rcls/discus/README.md

Discus is an 8-bit CPU built from discrete transistors.
[Refer to the website for documentation](http://rcls.github.io/discus)
