rcls/discus/docs/notps.md

# notps.sch schematic
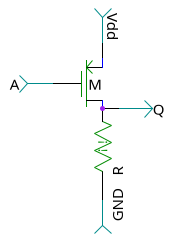
[picture p2: docs/notps.png]
notps.sch
