rcls/discus/docs/dram32byte.md

# dram32byte.sch schematic
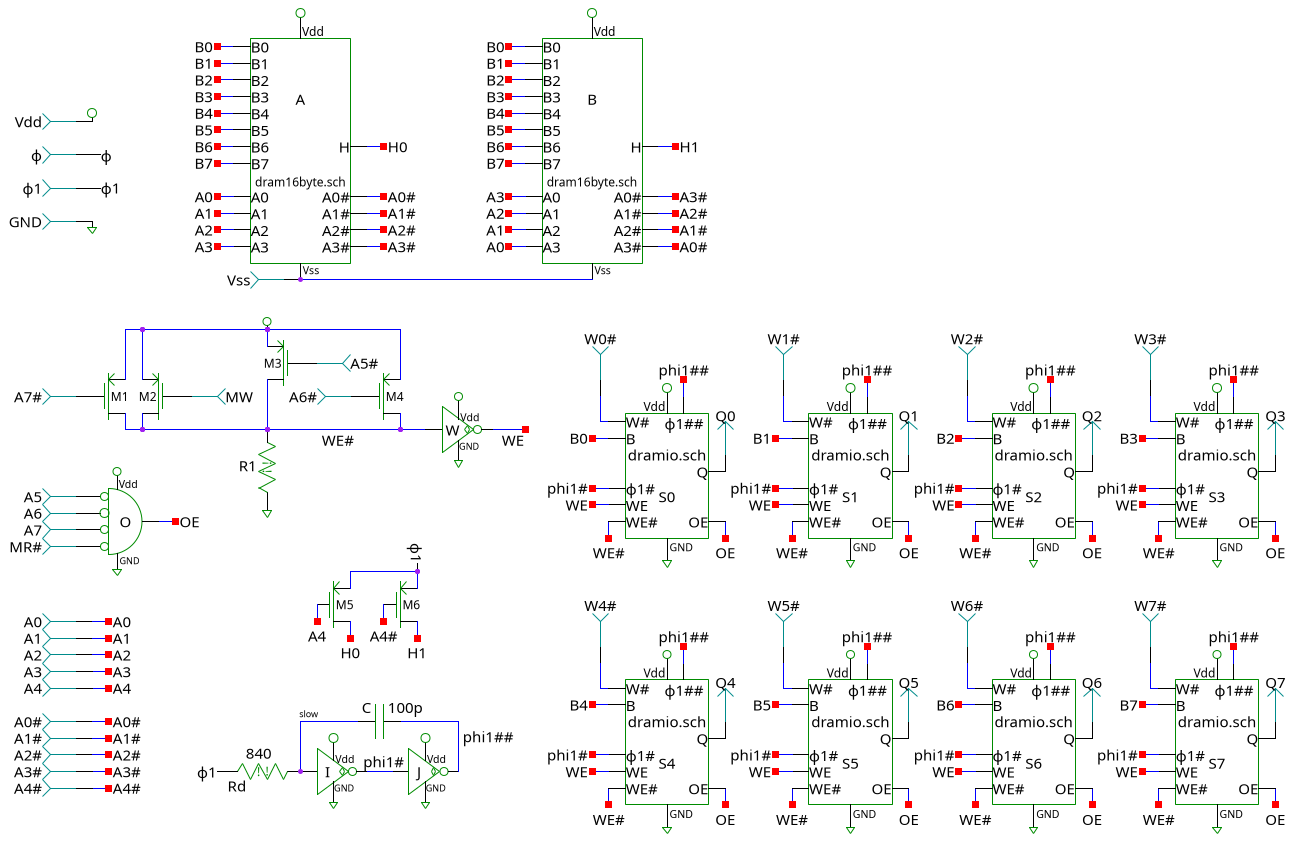
[picture p3: docs/dram32byte.png]
dram32byte.sch

# Gates in dram32byte.sch
dram16byte
dramio
nor4
cnot
