rcls/discus/docs/dram64byte.md

# dram64byte.sch schematic
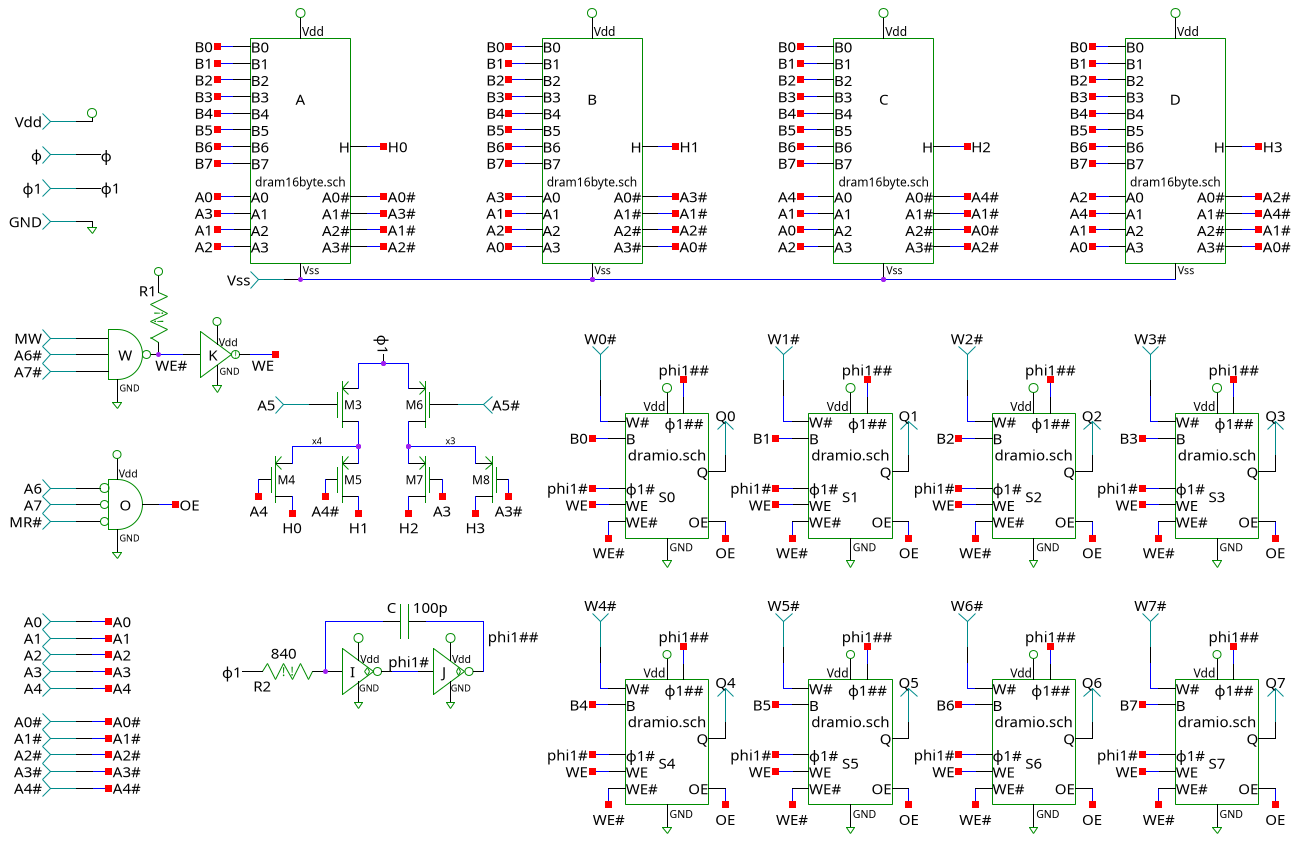
[picture p4: docs/dram64byte.png]
dram64byte.sch

# Gates in dram64byte.sch
dram16byte
dramio
nor3
nand3od
nots
cnot
