rcls/discus/docs/dramio.md

# dramio.sch schematic
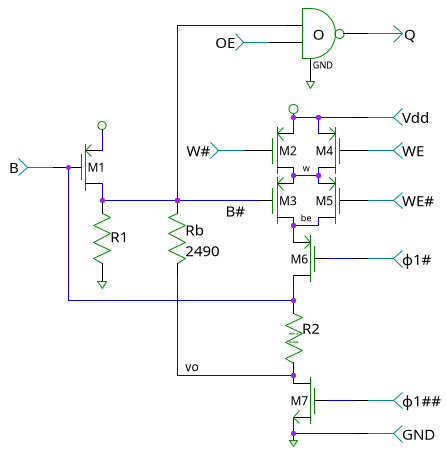
[picture p5: docs/dramio.png]
dramio.sch

# Gates in dramio.sch
nandod
