rcls/discus/docs/fivepd.md

# fivepd.sch schematic
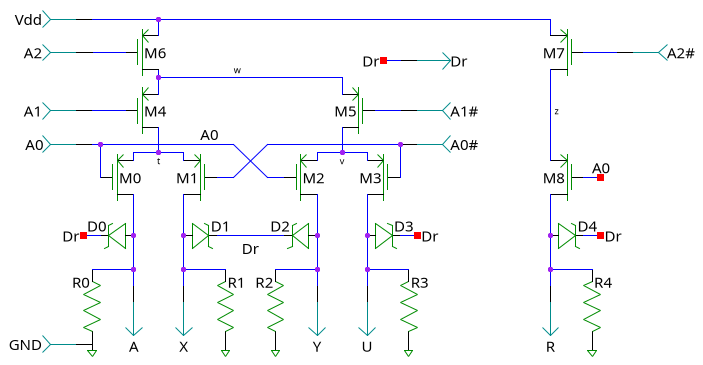
[picture p6: docs/fivepd.png]
fivepd.sch
