rcls/discus/docs/halfadd.md

# halfadd.sch schematic
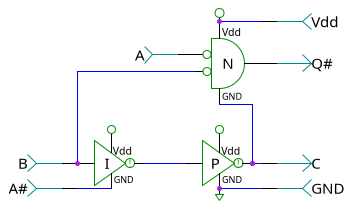
[picture p7: docs/halfadd.png]
halfadd.sch

# Gates in halfadd.sch
nots
nor
