rcls/discus/docs/nands.md

# nands.sch schematic
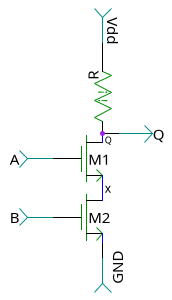
[picture p8: docs/nands.png]
nands.sch
