rcls/discus/docs/nors.md

# nors.sch schematic
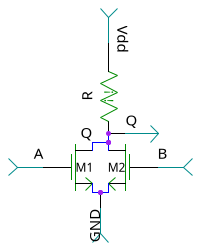
[picture p9: docs/nors.png]
nors.sch
