rcls/discus/docs/rom32byte.md

# rom32byte.sch schematic
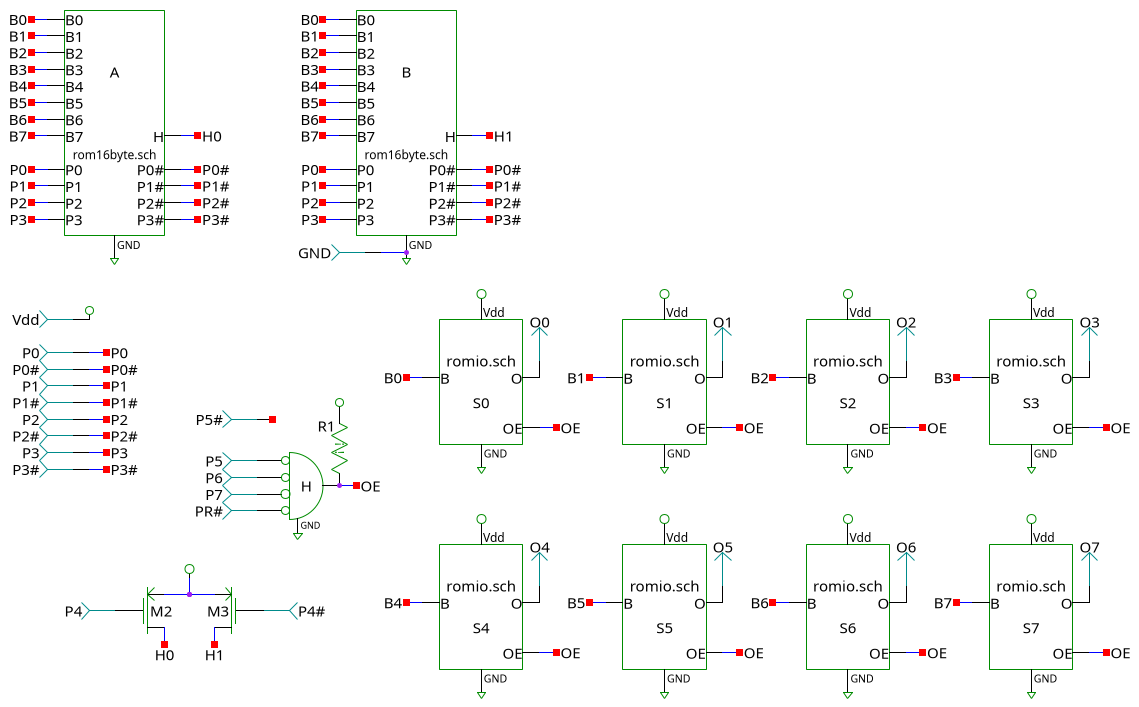
[picture p10: docs/rom32byte.png]
rom32byte.sch

# Gates in rom32byte.sch
rom16byte
romio
nor4od
