rcls/discus/docs/rom64byte.md

# rom64byte.sch schematic
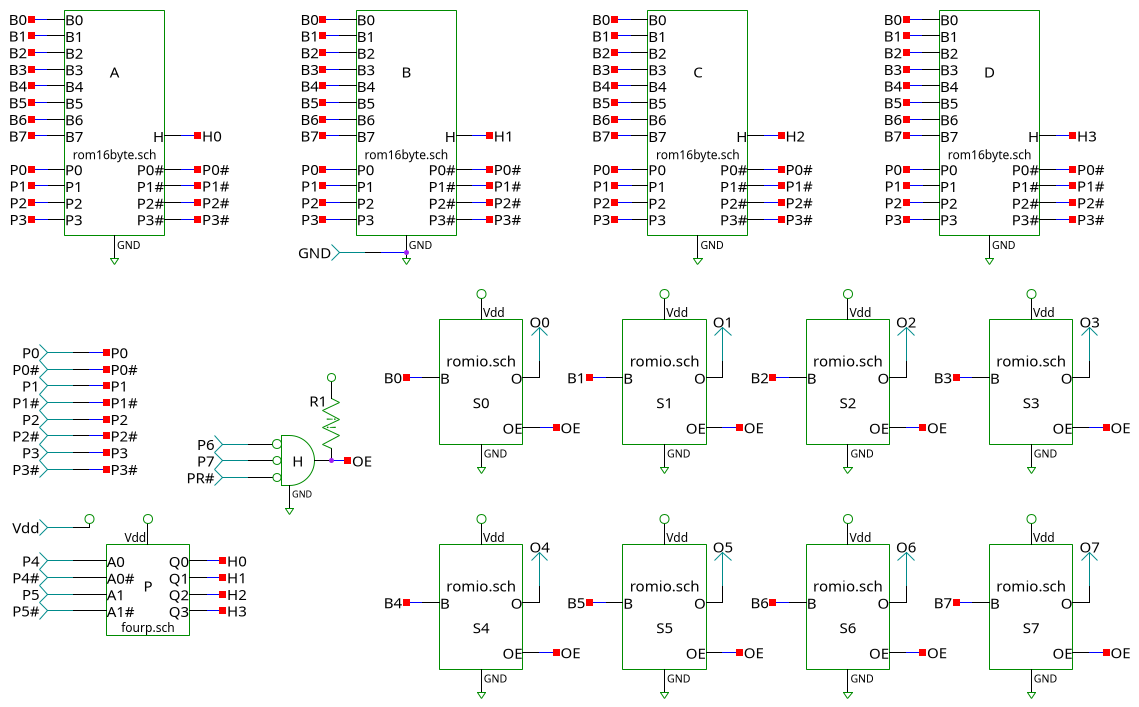
[picture p11: docs/rom64byte.png]
rom64byte.sch

# Gates in rom64byte.sch
rom16byte
romio
nor3od
fourp
