rcls/discus/docs/selis.md

# selis.sch schematic
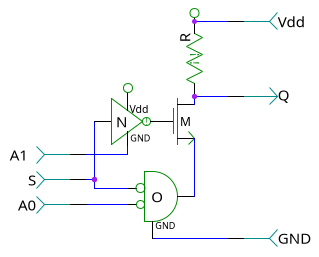
[picture p12: docs/selis.png]
selis.sch

# Gates in selis.sch
nots
norod
