rcls/discus/docs/sp.md

# sp.sch schematic
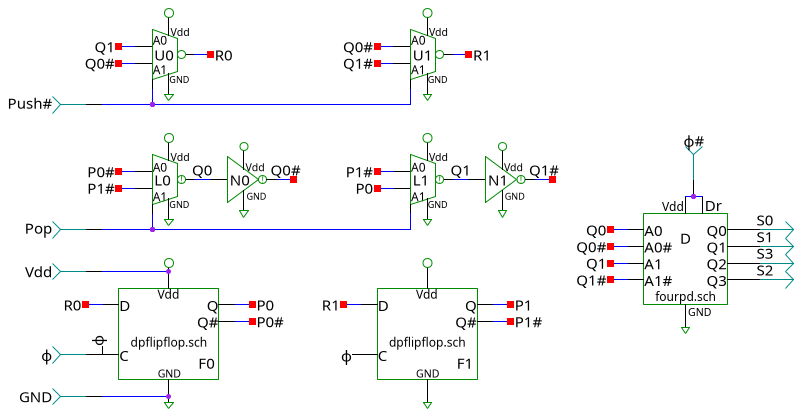
[picture p13: docs/sp.png]
sp.sch

# Gates in sp.sch
dpflipflop
selis
seli
nots
fourpd
