rcls/discus/docs/xnors.md

# xnors.sch schematic
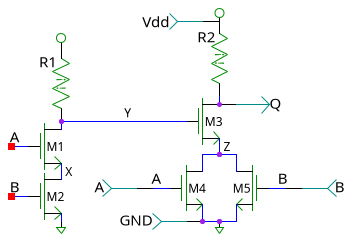
[picture p14: docs/xnors.png]
xnors.sch
