rcls/discus/docs/romio.md

# romio.sch schematic
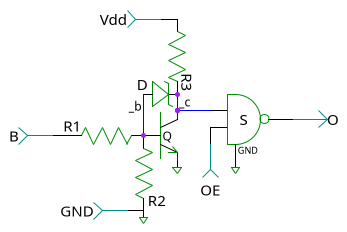
[picture p15: docs/romio.png]
romio.sch

# Gates in romio.sch
nandod
