rcls/discus/docs/fiveof8.md

# fiveof8.sch schematic
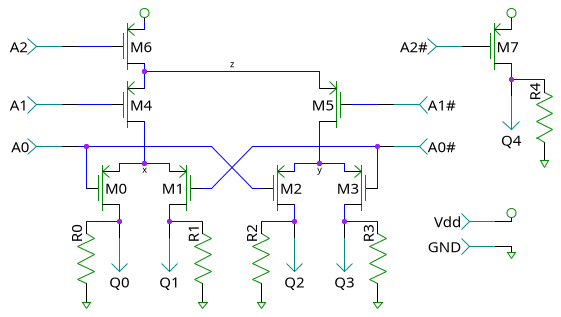
[picture p16: docs/fiveof8.png]
fiveof8.sch
