rcls/discus/docs/deflipflop.md

# deflipflop.sch schematic
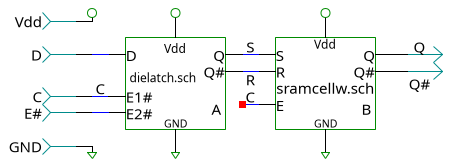
[picture p17: docs/deflipflop.png]
deflipflop.sch

# Gates in deflipflop.sch
sramcellw
dielatch
