rcls/discus/docs/dielatch.md

# dielatch.sch schematic
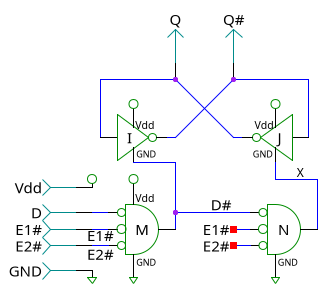
[picture p18: docs/dielatch.png]
dielatch.sch

# Gates in dielatch.sch
not
nor3
nor3od
