rcls/discus/docs/alu.md

# alu.sch schematic
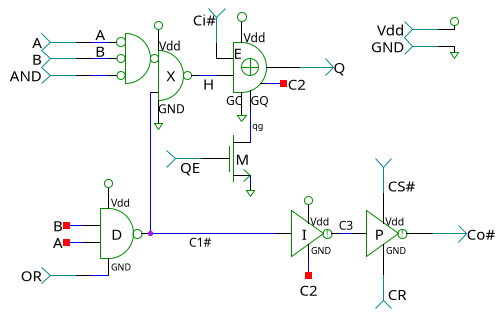
[picture p19: docs/alu.png]
alu.sch

# Gates in alu.sch
nand1or3
xor2g
nand
nots
