rcls/discus/docs/nots.md

# nots.sch schematic
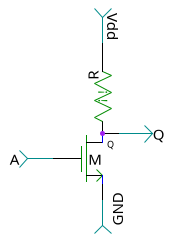
[picture p20: docs/nots.png]
nots.sch
