rcls/discus/docs/sramcell2t.md

# sramcell2t.sch schematic
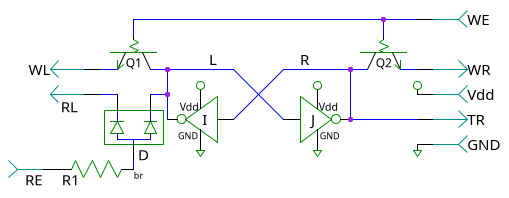
[picture p21: docs/sramcell2t.png]
sramcell2t.sch

# Gates in sramcell2t.sch
not
