rcls/discus/docs/nand3od.md

# nand3od.sch schematic
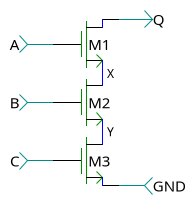
[picture p22: docs/nand3od.png]
nand3od.sch
