rcls/discus/docs/sramcellsw.md

# sramcellsw.sch schematic
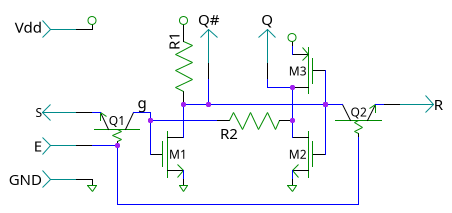
[picture p23: docs/sramcellsw.png]
sramcellsw.sch
