rcls/discus/docs/nor4od.md

# nor4od.sch schematic
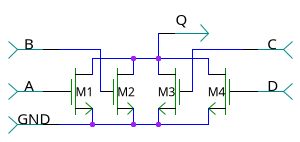
[picture p24: docs/nor4od.png]
nor4od.sch
