rcls/discus/docs/fourp.md

# fourp.sch schematic
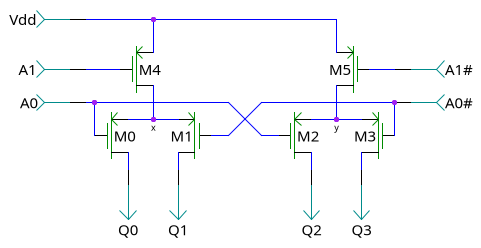
[picture p25: docs/fourp.png]
fourp.sch
