rcls/discus/docs/noverlap.md

# noverlap.sch schematic
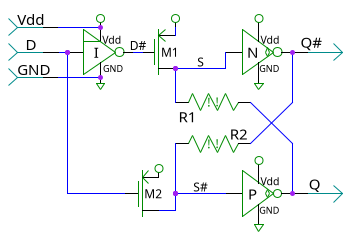
[picture p26: docs/noverlap.png]
noverlap.sch

# Gates in noverlap.sch
notp
cnot
