rcls/discus/docs/rom16byte.md

# rom16byte.sch schematic
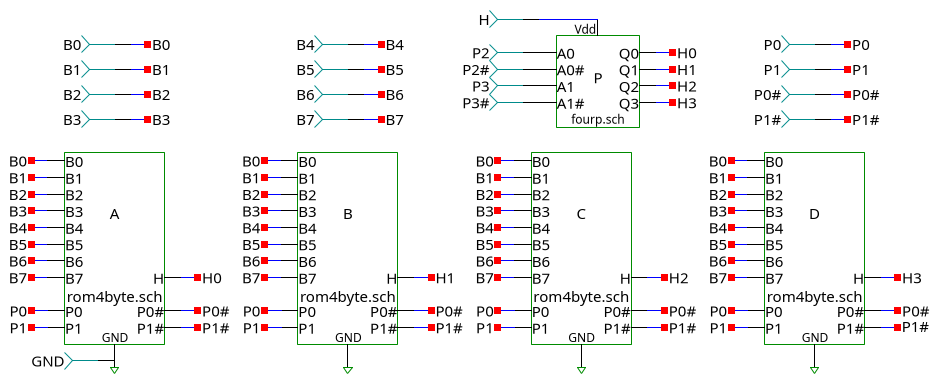
[picture p27: docs/rom16byte.png]
rom16byte.sch

# Gates in rom16byte.sch
rom4byte
fourp
