rcls/discus/docs/univlight.md

# univlight.sch schematic
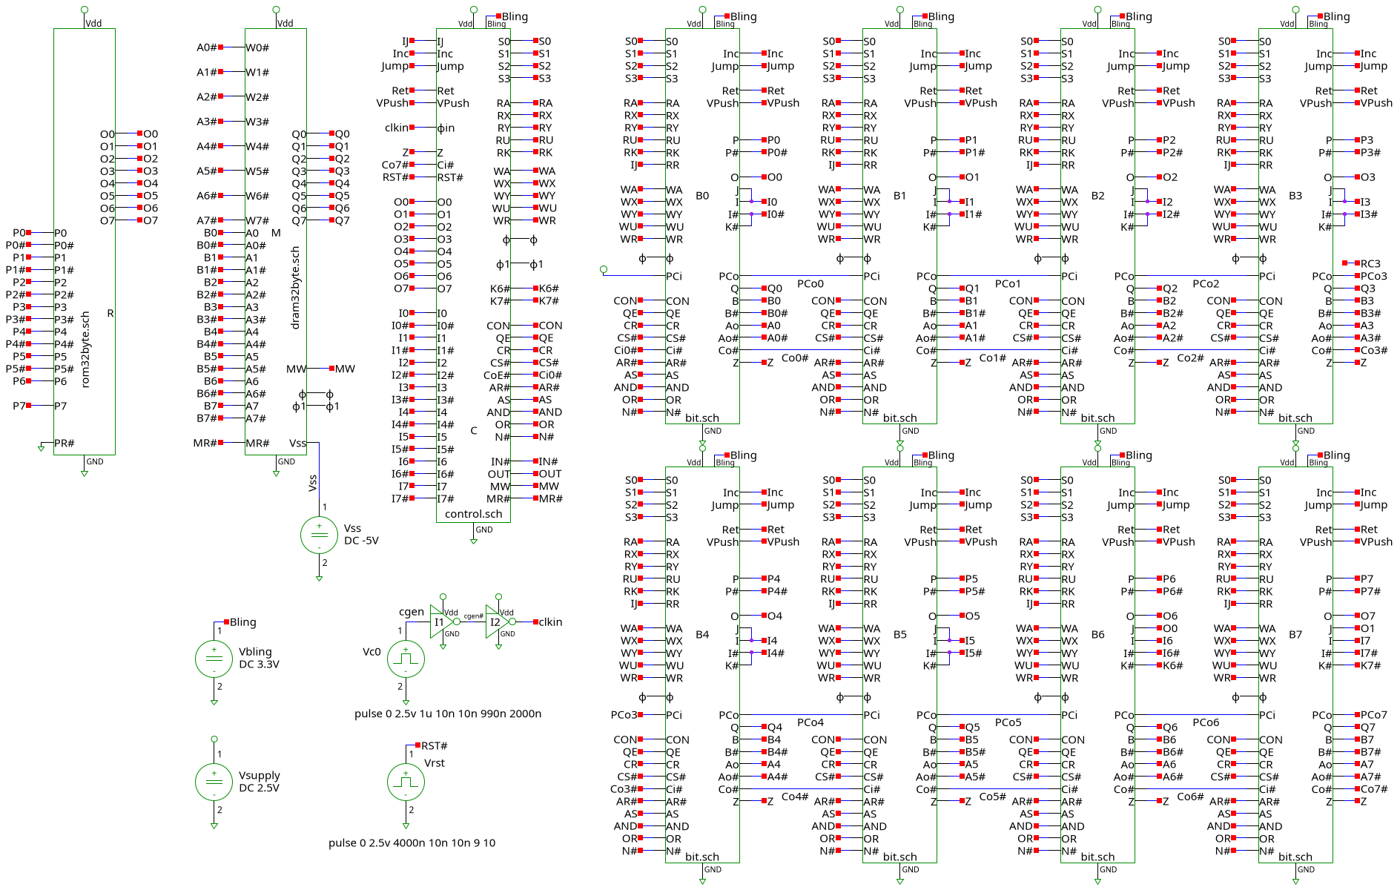
[picture p28: docs/univlight.png]
univlight.sch

# Gates in univlight.sch
rom64byte
control
bit
notp
dram64byte
