rcls/discus/docs/dflipflops.md

# dflipflops.sch schematic
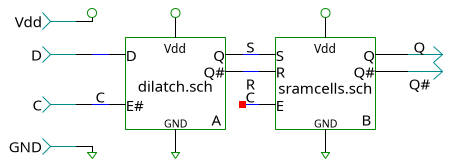
[picture p29: docs/dflipflops.png]
dflipflops.sch

# Gates in dflipflops.sch
sramcells
dilatch
