rcls/discus/docs/dilatch.md

# dilatch.sch schematic
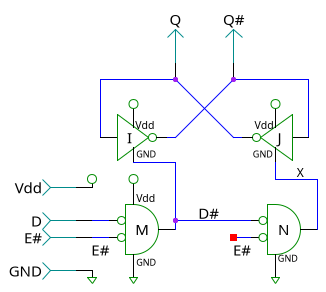
[picture p30: docs/dilatch.png]
dilatch.sch

# Gates in dilatch.sch
not
nor
norod
