rcls/discus/docs/diplatch.md

# diplatch.sch schematic
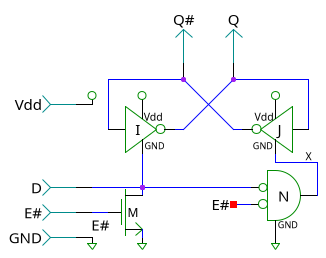
[picture p31: docs/diplatch.png]
diplatch.sch

# Gates in diplatch.sch
not
norod
