rcls/discus/docs/dpflipflop.md

# dpflipflop.sch schematic
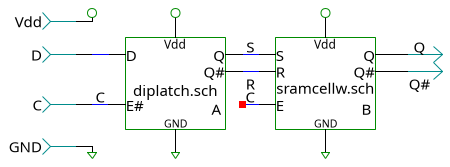
[picture p32: docs/dpflipflop.png]
dpflipflop.sch

# Gates in dpflipflop.sch
sramcellw
diplatch
