rcls/discus/docs/dpflipflops.md

# dpflipflops.sch schematic
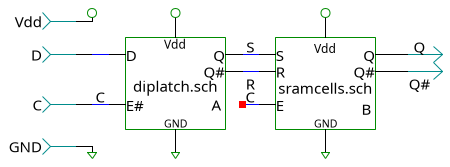
[picture p33: docs/dpflipflops.png]
dpflipflops.sch

# Gates in dpflipflops.sch
sramcells
diplatch
