rcls/discus/docs/sramcell2.md

# sramcell2.sch schematic
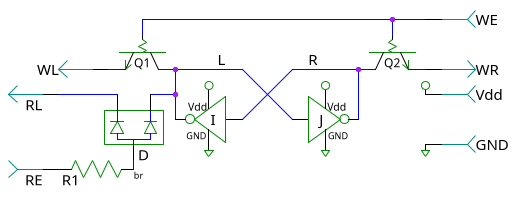
[picture p34: docs/sramcell2.png]
sramcell2.sch

# Gates in sramcell2.sch
not
