rcls/discus/docs/sramcells.md

# sramcells.sch schematic
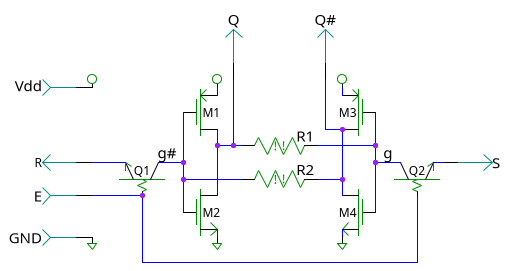
[picture p35: docs/sramcells.png]
sramcells.sch
