rcls/discus/docs/sramcellw.md

# sramcellw.sch schematic
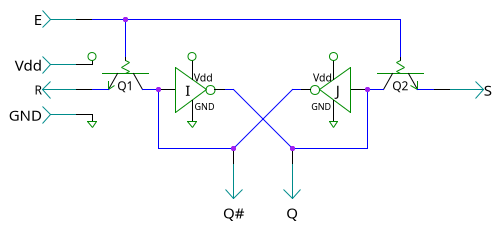
[picture p36: docs/sramcellw.png]
sramcellw.sch

# Gates in sramcellw.sch
not
