rcls/discus/docs/fourpd.md

# fourpd.sch schematic
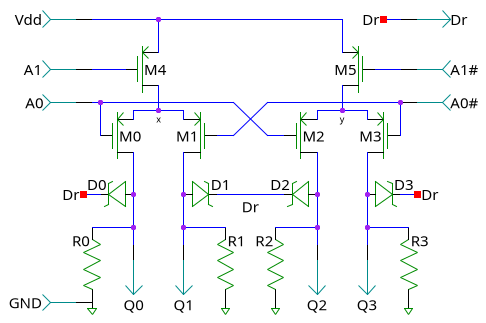
[picture p37: docs/fourpd.png]
fourpd.sch
