rcls/discus/docs/rom4byte.md

# rom4byte.sch schematic
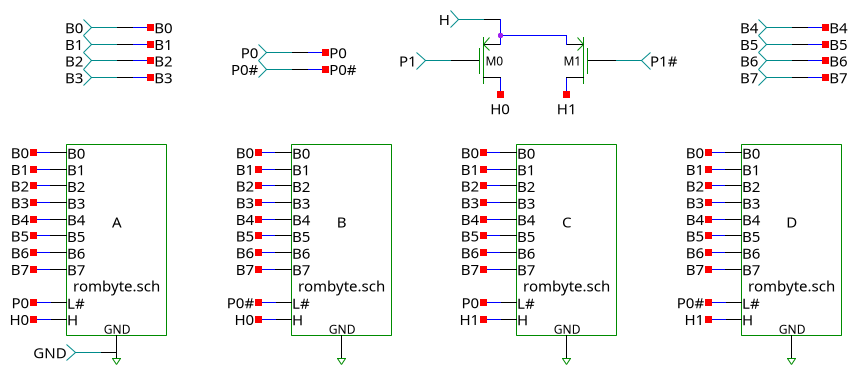
[picture p38: docs/rom4byte.png]
rom4byte.sch

# Gates in rom4byte.sch
rombyte
