rcls/discus/docs/rombyte.md

# rombyte.sch schematic
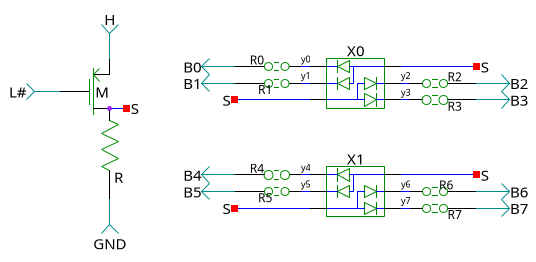
[picture p39: docs/rombyte.png]
rombyte.sch
