rcls/discus/docs/dram16byte.md

# dram16byte.sch schematic
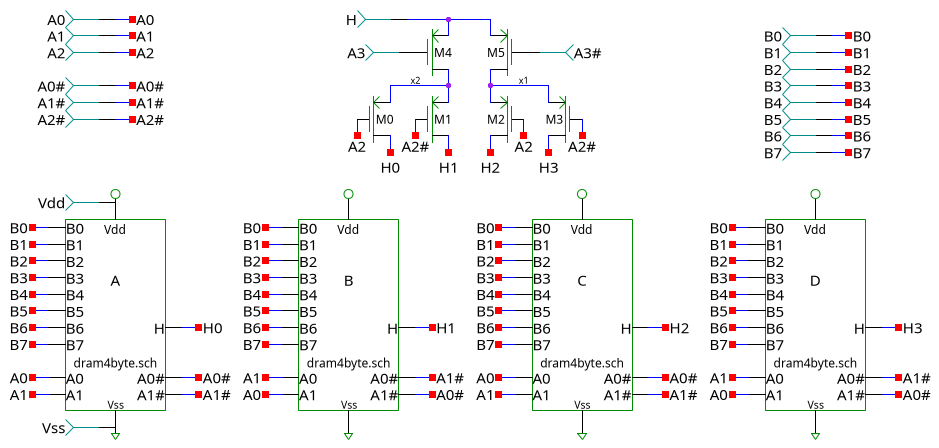
[picture p40: docs/dram16byte.png]
dram16byte.sch

# Gates in dram16byte.sch
dram4byte
