rcls/discus/docs/dram4byte.md

# dram4byte.sch schematic
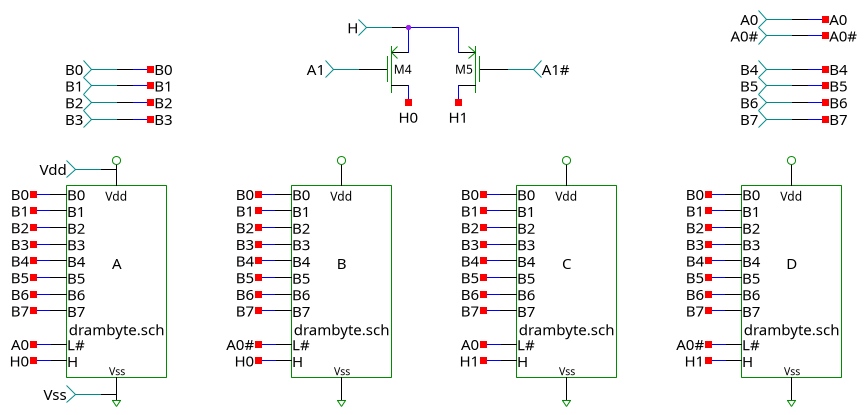
[picture p41: docs/dram4byte.png]
dram4byte.sch

# Gates in dram4byte.sch
drambyte
