rcls/discus/docs/seli.md

# seli.sch schematic
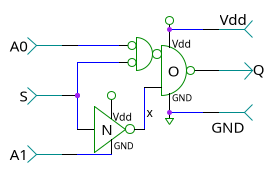
[picture p42: docs/seli.png]
seli.sch

# Gates in seli.sch
nand1or
not
