rcls/discus/docs/xnor.md

# xnor.sch schematic
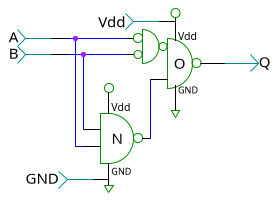
[picture p43: docs/xnor.png]
xnor.sch

# Gates in xnor.sch
nand
nand1or
