rcls/discus/docs/xor.md

# xor.sch schematic
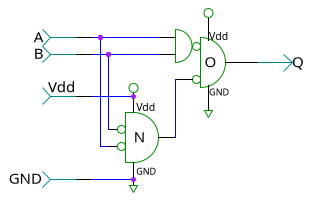
[picture p44: docs/xor.png]
xor.sch

# Gates in xor.sch
nor
nor1and
