rcls/discus/docs/xor2g.md

# xor2g.sch schematic
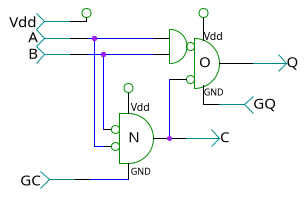
[picture p45: docs/xor2g.png]
xor2g.sch

# Gates in xor2g.sch
nor
nor1and
