rcls/discus/docs/drambyte.md

# drambyte.sch schematic
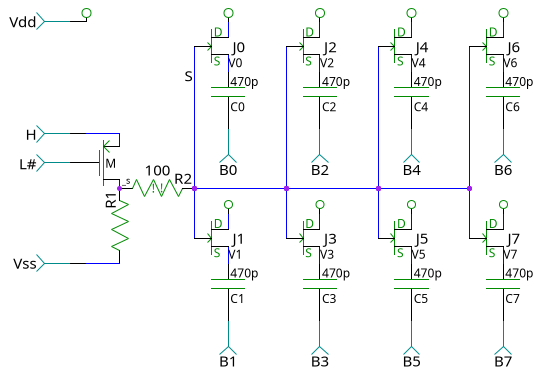
[picture p46: docs/drambyte.png]
drambyte.sch
