rcls/discus/docs/andnand.md

# andnand.sch schematic
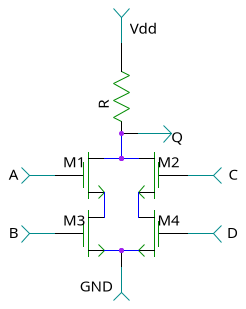
[picture p47: docs/andnand.png]
andnand.sch
