rcls/discus/docs/cnot.md

# cnot.sch schematic
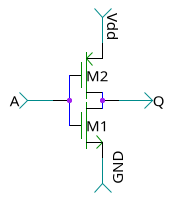
[picture p48: docs/cnot.png]
cnot.sch
