rcls/discus/docs/nand.md

# nand.sch schematic
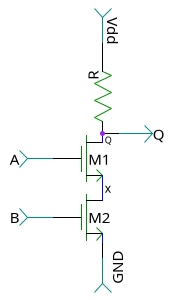
[picture p49: docs/nand.png]
nand.sch
