rcls/discus/docs/nand1or.md

# nand1or.sch schematic
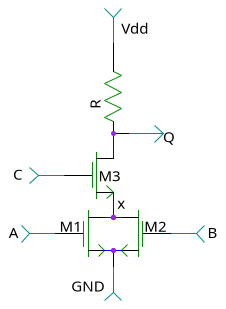
[picture p50: docs/nand1or.png]
nand1or.sch
