rcls/discus/docs/nand1or3.md

# nand1or3.sch schematic
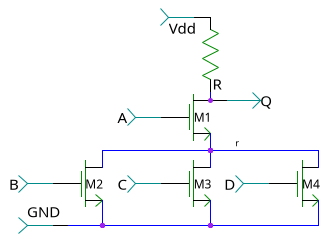
[picture p51: docs/nand1or3.png]
nand1or3.sch
