rcls/discus/docs/nand3.md

# nand3.sch schematic
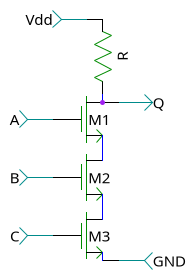
[picture p52: docs/nand3.png]
nand3.sch
