rcls/discus/docs/nandod.md

# nandod.sch schematic
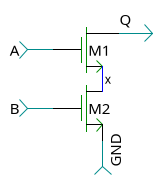
[picture p53: docs/nandod.png]
nandod.sch
