rcls/discus/docs/nor1and.md

# nor1and.sch schematic
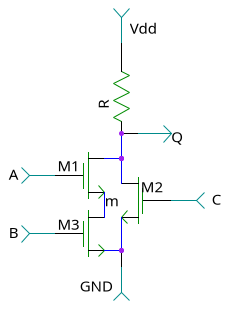
[picture p54: docs/nor1and.png]
nor1and.sch
