rcls/discus/docs/nor3.md

# nor3.sch schematic
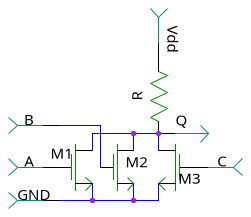
[picture p55: docs/nor3.png]
nor3.sch
