rcls/discus/docs/nor3od.md

# nor3od.sch schematic
nor3od.sch
