rcls/discus/docs/nor4.md

# nor4.sch schematic
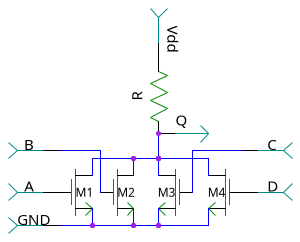
[picture p56: docs/nor4.png]
nor4.sch
