rcls/discus/docs/norod.md

# norod.sch schematic
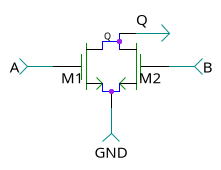
[picture p57: docs/norod.png]
norod.sch
