rcls/discus/docs/notb.md

# notb.sch schematic
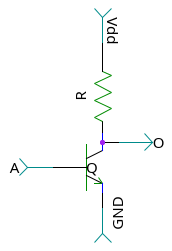
[picture p58: docs/notb.png]
notb.sch
