rcls/discus/docs/notp.md

# notp.sch schematic
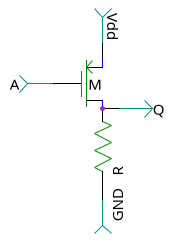
[picture p59: docs/notp.png]
notp.sch
