rcls/discus/docs/sramcell.md

# sramcell.sch schematic
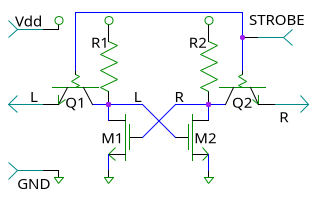
[picture p60: docs/sramcell.png]
sramcell.sch
