rcls/discus/docs/sramcell2s.md

# sramcell2s.sch schematic
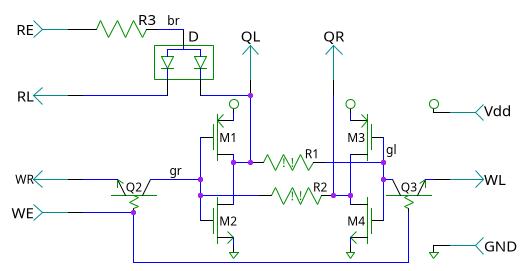
[picture p61: docs/sramcell2s.png]
sramcell2s.sch
