rcls/discus/io/tps7a7200.pins.txt

50mV 5
100mV 6
200mV 7
400mV 9
800mV 10
1.6V 11
EN 14
FB 3
GND 8,18
IN 15,16,17
NC 12
OUT 1,19,20
PG 4
SNS 2
SS 13
PAD 0
