rcls/discus/docs/bit.md

# bit.sch schematic
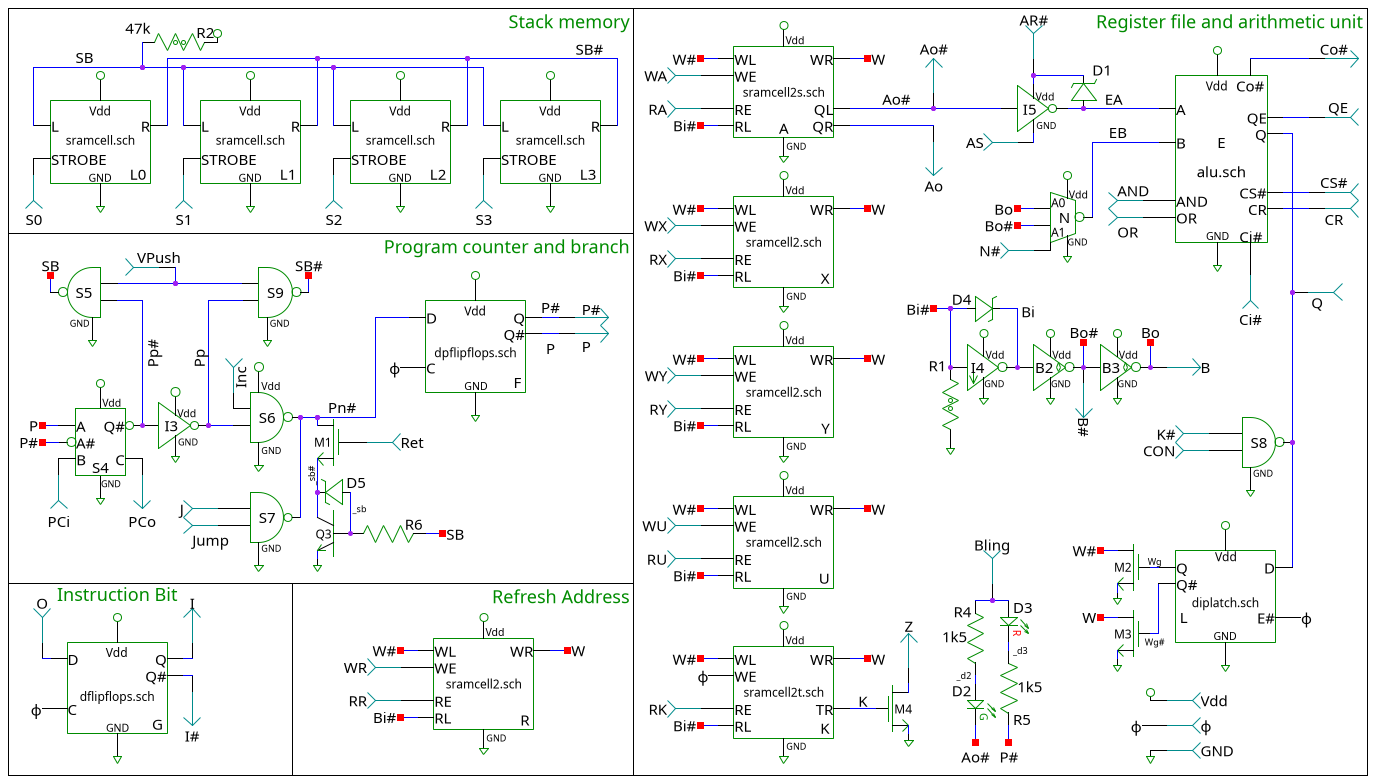
[picture p62: docs/bit.png]
bit.sch

# Gates in bit.sch
alu
sramcell2
sramcell2s
not
sramcell
dpflipflops
dflipflops
sramcell2t
nandod
notb
nand
cnot
seli
halfadd
diplatch
