rcls/discus/docs/decode.md

# decode.sch schematic
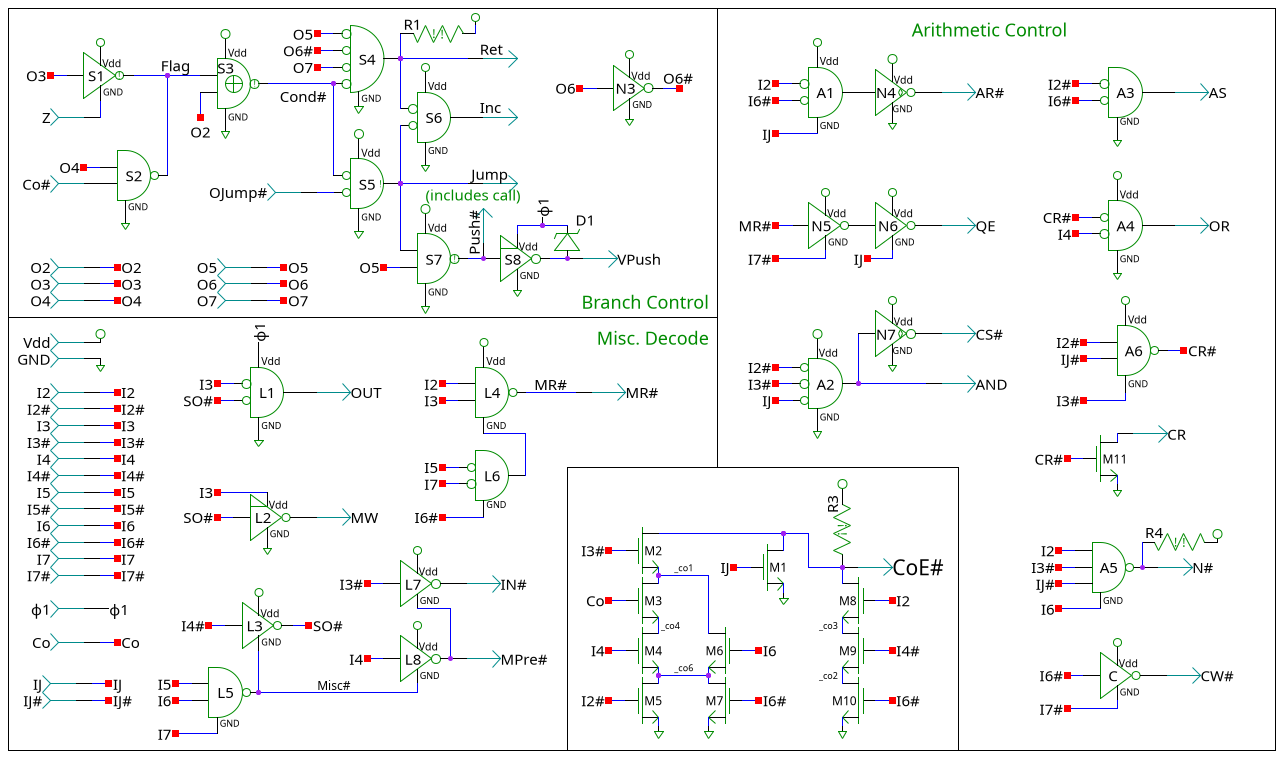
[picture p63: docs/decode.png]
decode.sch

# Gates in decode.sch
nors
nor
cnot
not
norod
xnors
notp
nands
nand3od
nor4od
nor3
nandod
nots
nand
