rcls/discus/docs/control.md

# control.sch schematic
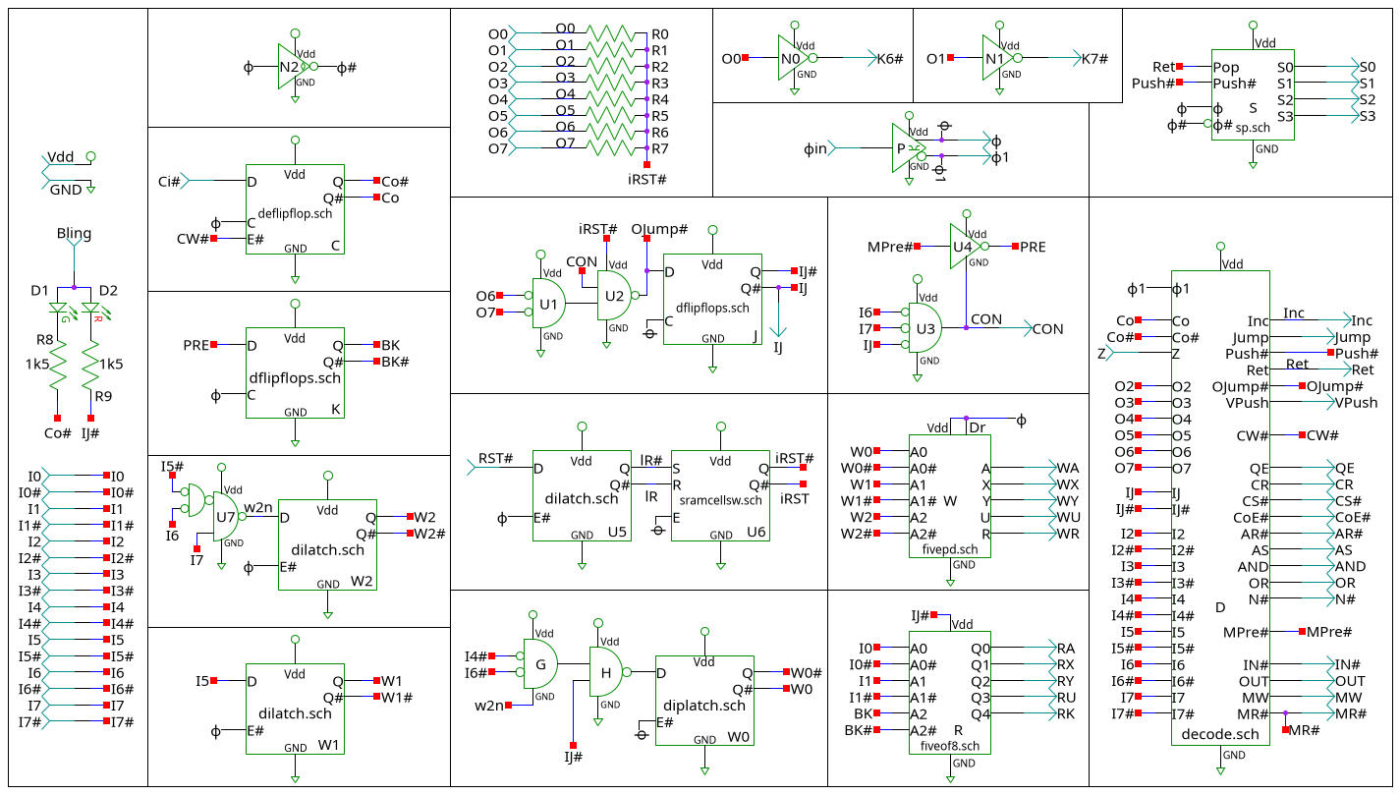
[picture p64: docs/control.png]
control.sch

# Gates in control.sch
deflipflop
dflipflops
not
sp
decode
nor
nor3
fivepd
noverlap
cnot
diplatch
dilatch
fiveof8
nand
sramcellsw
nand1or
