rcls/discus/docs/control-top.png

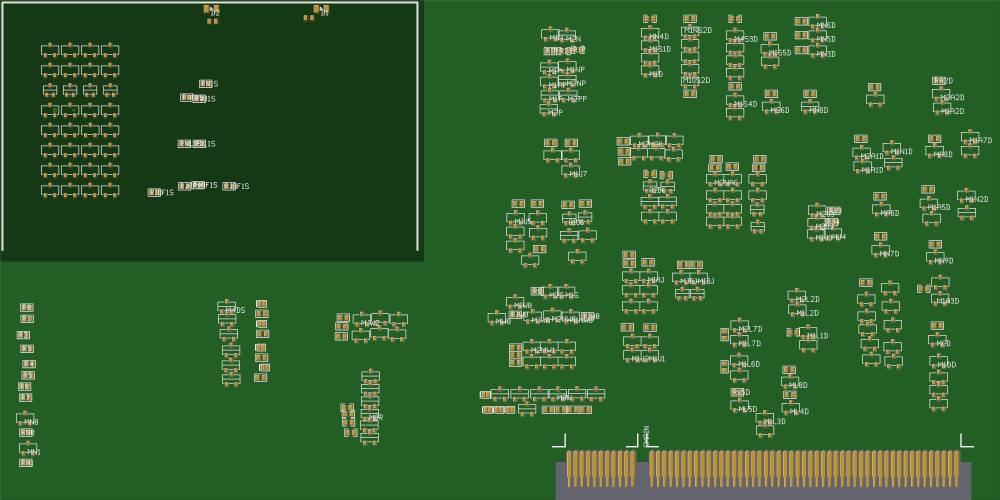
docs/control-top.png
