rcls/discus/(list of files, drawings)

Other design files:
board/bit-board.pcb
board/control-board.pcb
fp/pci-conn-3v.pcb
fp/pci-edge-3v.pcb
