rcls/discus/control-board.kicad_pcb

## KiCad design control-board.kicad_pcb (2026-03-17)

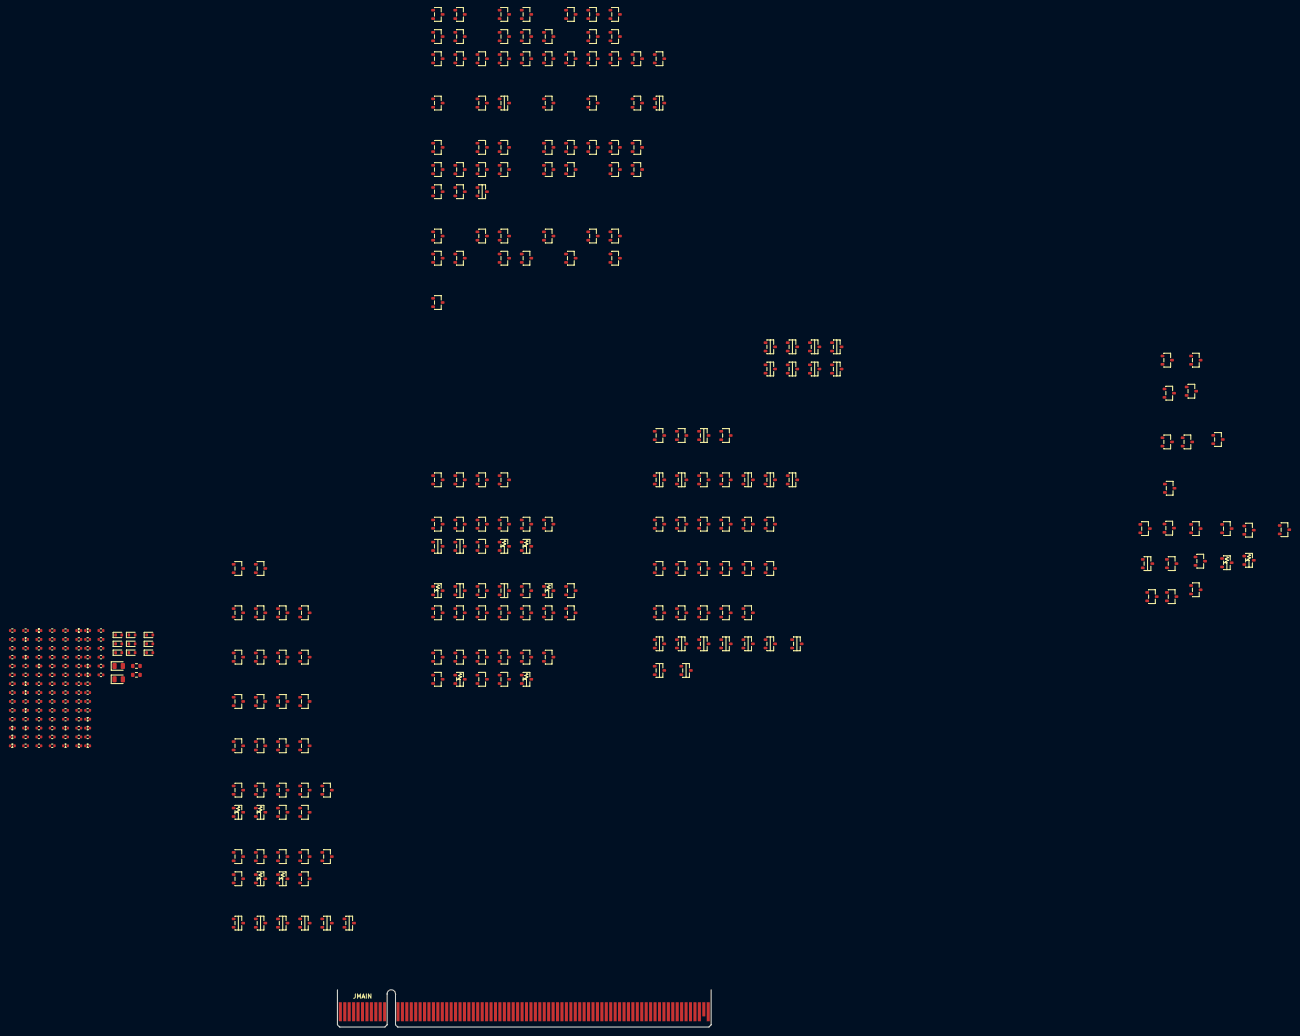
[picture p66: board control-board.kicad_pcb from above]

Board: 4 copper layers, 331 parts (0 on the bottom side), 182 nets, no tracks yet.

Parts:
D0DS, D0W, D1DS, D1W, D2DS, D2W, D3DS, D3W, D4W: RB751S40; SOD523
D1: ledgreen; 0805-diode
D2: ledred; 0805-diode
JMAIN: unknown; BUS_PCIexpress_x16
M0DS, M0R, M0W, M1BJ, M1BK, M1DS, M1P, M1R, M1W, M2DS, M2N2, M2N4D, M2N7D, M2NP, M2P, M2PP, M2R, M2W, M3BJ, M3BK, M3DS, M3R, M3U6, M3W, M4DS, M4R, M4W, M5DS, M5R, M5W, M6R, M6W, M7R, M7W, M8W: NX3008PBK; SOT23_pmos
M1A1D, M1A2D, M1A3D, M1A4D, M1A5D, M1A6D, M1D, M1G, M1H, M1L2D, M1L4D, M1L5D, M1L6D, M1MAC, M1MAJ, M1MAK, M1MU5, M1MW1, M1MW2, M1N2, M1N4D, M1N7D, M1NAC, M1NAF0S, M1NAF1S, M1NAJ, M1NAK, M1NP, M1NU5, M1NW0, M1NW1, M1NW2, M1OL0S, M1OL1S, M1OU0S, M1OU1S, M1PP, M1S2D, M1S3D, M1S4D, M1S5D, M1S6D, M1S7D, M1U1, M1U2, M1U3, M1U6, M1U7, M2A1D, M2A2D, M2A3D, M2A4D, M2A5D, M2A6D, M2BJ, M2BK, M2D, M2G, M2H, M2L2D, M2L4D, M2L5D, M2L6D, M2MAC, M2MAJ, M2MAK, M2MU5, M2MW1, M2MW2, M2NAC, M2NAF0S, M2NAF1S, M2NAJ, M2NAK, M2NU5, M2NW0, M2NW1, M2NW2, M2OL0S, M2OL1S, M2OU0S, M2OU1S, M2S2D, M2S3D, M2S4D, M2S5D, M2S6D, M2S7D, M2U1, M2U2, M2U3, M2U6, M2U7, M3A2D, M3A5D, M3D, M3MAC, M3NAC, M3OU0S, M3OU1S, M3S3D, M3S4D, M3U3, M3U7, M4BJ, M4BK, M4D, M4S3D, M4S4D, M5D, M5S3D, M6D, M7D, M8D, M9D, M10D, M11D: FDV301N; SOT23_nmos
MAF0S, MAF1S: FDV301N; SOT23_nmos
MCD: FDV301N; SOT23_nmos
MIAC: FDV301N; SOT23_nmos
MIAF0S, MIAF1S: FDV301N; SOT23_nmos
MIAJ: FDV301N; SOT23_nmos
MIAK: FDV301N; SOT23_nmos
MIBC: FDV301N; SOT23_nmos
MIBF0S, MIBF1S: FDV301N; SOT23_nmos
MIP: NX3008PBK; SOT23_pmos
MIU5: FDV301N; SOT23_nmos
MIW0, MIW1, MIW2: FDV301N; SOT23_nmos
MJAC: FDV301N; SOT23_nmos
MJAF0S, MJAF1S: FDV301N; SOT23_nmos
MJAJ: FDV301N; SOT23_nmos
MJAK: FDV301N; SOT23_nmos
MJBC: FDV301N; SOT23_nmos
MJBF0S, MJBF1S: FDV301N; SOT23_nmos
MJU5: FDV301N; SOT23_nmos
MJW0, MJW1, MJW2: FDV301N; SOT23_nmos
ML0S, ML1D, ML1S, ML3D, ML7D, ML8D: FDV301N; SOT23_nmos
MN0, MN0S, MN1, MN1S, MN3D, MN5D, MN6D: FDV301N; SOT23_nmos
MNL0S, MNL1S: FDV301N; SOT23_nmos
MNU0S, MNU1S: FDV301N; SOT23_nmos
MS1D: FDV301N; SOT23_nmos
MS8D: NX3008PBK; SOT23_pmos
MU4: FDV301N; SOT23_nmos
MW0: FDV301N; SOT23_nmos
Q1BC, Q1BF0S, Q1BF1S, Q1BJ, Q1BK, Q1U6, Q2BC, Q2BF0S, Q2BF1S, Q2BJ, Q2BK, Q2U6: PDTC124TU; SOT23_bias
R0, R0DS, R0R, R0W, R1, R1DS, R1R, R1U6, R1W, R2, R2DS, R2R, R2U6, R2W, R3, R3DS, R3R, R3W, R4, R4R, R4W, R5, R6, R7: 2k49; R_0402_load
R1BJ, R1BK, R1D, R1P, R1S3D, R2BJ, R2BK, R2P, R2S3D, R3D, R4D: 820; R_0402_strong
R8, R9: 1k5; 0603
RA1D, RA2D, RA4D, RA6D: 2k49; R_0402_load
RCD: 2k49; R_0402_load
RG: 2k49; R_0402_load
RH: 2k49; R_0402_load
RIAC: 2k49; R_0402_load
RIAF0S, RIAF1S: 2k49; R_0402_load
RIAJ: 2k49; R_0402_load
RIAK: 2k49; R_0402_load
RIBC: 2k49; R_0402_load
RIBF0S, RIBF1S: 2k49; R_0402_load
RIP: 2k49; R_0402_load
RIU5: 2k49; R_0402_load
RIW0, RIW1, RIW2: 2k49; R_0402_load
RJAC: 2k49; R_0402_load
RJAF0S, RJAF1S: 2k49; R_0402_load
RJAJ: 2k49; R_0402_load
RJAK: 2k49; R_0402_load
RJBC: 2k49; R_0402_load
RJBF0S, RJBF1S: 2k49; R_0402_load
RJU5: 2k49; R_0402_load
RJW0, RJW1, RJW2: 2k49; R_0402_load
RL0S, RL1S, RL2D: 820; R_0402_strong
RL1D, RL3D, RL4D, RL7D, RL8D: 2k49; R_0402_load
RMAC: 2k49; R_0402_load
RMAJ: 2k49; R_0402_load
RMAK: 2k49; R_0402_load
RMU5: 2k49; R_0402_load
RMW1, RMW2: 2k49; R_0402_load
RN0, RN1, RN3D, RN5D, RN6D: 2k49; R_0402_load
RN0S, RN1S: 820; R_0402_strong
RNL0S, RNL1S: 820; R_0402_strong
RNU0S, RNU1S: 2k49; R_0402_load
ROU0S, ROU1S: 2k49; R_0402_load
RS1D, RS5D, RS7D: 820; R_0402_strong
RS6D, RS8D: 2k49; R_0402_load
RU1, RU2, RU3, RU4, RU7: 2k49; R_0402_load

Connections:
AND: JMAIN.B60, M1A2D.3 (D), M1N7D.1 (G), M2A2D.3 (D), M2N7D.1 (G), M3A2D.3 (D), RA2D.1
AR#: JMAIN.B58, M1N4D.3 (D), M2N4D.3 (D)
AS: JMAIN.B59, M1A3D.3 (D), M2A3D.3 (D)
BK: M1BK.3 (D), M2BK.3 (D), M6R.1 (G), R1BK.1
BK#: M3BK.3 (D), M4BK.3 (D), M7R.1 (G), R2BK.2
Bling: D1.2, D2.2, JMAIN.B67
CON: JMAIN.B53, M1U2.1 (G), M1U3.3 (D), M2U3.3 (D), M3U3.3 (D), MU4.2 (S), RU3.1
CR: JMAIN.B55, M11D.3 (D)
CR#_D: M1A4D.1 (G), M1A6D.3 (D), M11D.1 (G), RA6D.1
CS#: JMAIN.B56, M1N7D.3 (D), M2N7D.3 (D)
CW#: M3MAC.1 (G), M3NAC.1 (G), MCD.3 (D), RCD.1
Ci#: JMAIN.B7, M1MAC.1 (G)
Co: M3D.1 (G), MIBC.1 (G), MJBC.3 (D), Q1BC.3, RJBC.1
Co#: M2S2D.1 (G), MIBC.3 (D), MJBC.1 (G), Q2BC.3, R8.1, RIBC.1
CoE#: JMAIN.B57, M1D.3 (D), M2D.3 (D), M8D.3 (D), R3D.1
Cond#_D: M1S5D.1 (G), M3S3D.3 (D), M4S4D.1 (G), R2S3D.1
D#_A_C: M1MAC.3 (D), M1NAC.1 (G), M2MAC.3 (D), M3MAC.3 (D), MIAC.2 (S), RMAC.1
D#_A_J: M1MAJ.3 (D), M1NAJ.1 (G), M2MAJ.3 (D), MIAJ.2 (S), RMAJ.1
D#_A_K: M1MAK.3 (D), M1NAK.1 (G), M2MAK.3 (D), MIAK.2 (S), RMAK.1
D#_U5: M1MU5.3 (D), M1NU5.1 (G), M2MU5.3 (D), MIU5.2 (S), RMU5.1
D#_W1: M1MW1.3 (D), M1NW1.1 (G), M2MW1.3 (D), MIW1.2 (S), RMW1.1
D#_W2: M1MW2.3 (D), M1NW2.1 (G), M2MW2.3 (D), MIW2.2 (S), RMW2.1
Flag_D: M1S2D.3 (D), M1S3D.1 (G), M4S3D.1 (G), MS1D.3 (D), RS1D.1
GND: JMAIN.B34, M1A2D.2 (S), M1A3D.2 (S), M1A4D.2 (S), M1D.2 (S), M1L2D.2 (S), M1MAC.2 (S), M1MAJ.2 (S), M1MAK.2 (S), M1MU5.2 (S), M1MW1.2 (S), M1MW2.2 (S), M1N2.2 (S), M1N4D.2 (S), M1N7D.2 (S), M1NAC.2 (S), M1NAF0S.2 (S), M1NAF1S.2 (S), M1NAJ.2 (S), M1NAK.2 (S), M1NP.2 (S), M1NU5.2 (S), M1NW0.2 (S), M1NW1.2 (S), M1NW2.2 (S), M1OL0S.2 (S), M1OL1S.2 (S), M1OU0S.2 (S), M1OU1S.2 (S), M1PP.2 (S), M1S4D.2 (S), M1S5D.2 (S), M1S6D.2 (S), M1U1.2 (S), M1U3.2 (S), M1U6.2 (S), M1U7.2 (S), M2A2D.2 (S), M2A3D.2 (S), M2A4D.2 (S), M2BJ.2 (S), M2BK.2 (S), M2H.2 (S), M2L2D.2 (S), M2MAC.2 (S), M2MAJ.2 (S), M2MAK.2 (S), M2MU5.2 (S), M2MW1.2 (S), M2MW2.2 (S), M2NAC.2 (S), M2NAF0S.2 (S), M2NAF1S.2 (S), M2NAJ.2 (S), M2NAK.2 (S), M2NU5.2 (S), M2NW0.2 (S), M2NW1.2 (S), M2NW2.2 (S), M2OL0S.2 (S), M2OL1S.2 (S), M2OU0S.2 (S), M2OU1S.2 (S), M2S2D.2 (S), M2S3D.2 (S), M2S4D.2 (S), M2S5D.2 (S), M2S6D.2 (S), M2S7D.2 (S), M2U1.2 (S), M2U2.2 (S), M2U3.2 (S), M2U6.2 (S), M2U7.2 (S), M3A2D.2 (S), M3MAC.2 (S), M3NAC.2 (S), M3S4D.2 (S), M3U3.2 (S), M4BJ.2 (S), M4BK.2 (S), M4S3D.2 (S), M4S4D.2 (S), M5D.2 (S), M5S3D.2 (S), M7D.2 (S), M10D.2 (S), M11D.2 (S), MAF0S.2 (S), MAF1S.2 (S), MIBC.2 (S), MIBF0S.2 (S), MIBF1S.2 (S), MJBC.2 (S), MJBF0S.2 (S), MJBF1S.2 (S), MN0.2 (S), MN0S.2 (S), MN1.2 (S), MN1S.2 (S), MN3D.2 (S), MW0.2 (S), R0DS.1, R0R.1, R0W.1, R1DS.1, R1R.1, R1W.1, R2DS.1, R2R.1, R2W.1, R3DS.1, R3R.1, R3W.1, R4R.1, R4W.1, RIP.1, RS8D.1
I0: JMAIN.B17, M0R.1 (G), M2R.1 (G)
I0#: JMAIN.B18, M1R.1 (G), M3R.1 (G)
I1: JMAIN.B19, M4R.1 (G)
I1#: JMAIN.B20, M5R.1 (G)
I2: JMAIN.B21, M1A1D.1 (G), M1A5D.1 (G), M1L4D.1 (G), M8D.1 (G)
I2#: JMAIN.B22, M1A2D.1 (G), M1A3D.1 (G), M1A6D.1 (G), M5D.1 (G)
I3: JMAIN.B23, M2L4D.1 (G)
I3#: JMAIN.B24, M1L2D.1 (G), M2A2D.1 (G), M2A5D.1 (G), M2A6D.2 (S), M2D.1 (G), ML1D.1 (G), ML7D.1 (G)
I4: JMAIN.B25, M2A4D.1 (G), M4D.1 (G), ML8D.1 (G)
I4#: JMAIN.B26, M1G.1 (G), M9D.1 (G), ML3D.1 (G)
I5: JMAIN.B27, M1L6D.1 (G), M1MW1.1 (G)
I5#: JMAIN.B28, M1U7.1 (G), M2L5D.2 (S)
I6: JMAIN.B29, M1L5D.1 (G), M1U3.1 (G), M2U7.1 (G), M3A5D.2 (S), M6D.1 (G)
I6#: JMAIN.B30, M1L6D.2 (S), M2A1D.1 (G), M2A3D.1 (G), M2G.1 (G), M2L6D.2 (S), M7D.1 (G), M10D.1 (G), MCD.1 (G)
I7: JMAIN.B31, M2L6D.1 (G), M2U3.1 (G), M3U7.1 (G)
I7#: JMAIN.B32, M2L5D.1 (G), MCD.2 (S), MN5D.2 (S)
IJ: JMAIN.B68, M1A1D.2 (S), M1D.1 (G), M2A1D.2 (S), M3A2D.1 (G), M3BJ.3 (D), M3U3.1 (G), M4BJ.3 (D), MN6D.2 (S), R2BJ.2
IJ#: M1BJ.3 (D), M2A6D.1 (G), M2BJ.3 (D), M2H.1 (G), M3A5D.1 (G), M6R.2 (S), M7R.2 (S), R1BJ.1, R9.1
IN#: JMAIN.B63, ML7D.3 (D), RL7D.1
Inc: JMAIN.B1, M1S6D.3 (D), M2S6D.3 (D), RS6D.1
Jump: JMAIN.B2, M1S5D.3 (D), M1S7D.1 (G), M2S5D.3 (D), M2S6D.1 (G), RS5D.1
K6#: JMAIN.B51, MN0.3 (D), RN0.1
K7#: JMAIN.B52, MN1.3 (D), RN1.1
MPre#: ML7D.2 (S), ML8D.3 (D), MU4.1 (G), RL8D.1
MR#: JMAIN.B66, M1L4D.3 (D), MN5D.1 (G), RL4D.1
MW: JMAIN.B65, M1L2D.3 (D), M2L2D.3 (D), RL2D.1
Misc#_D: M1L5D.3 (D), ML3D.2 (S), ML8D.2 (S)
N#: JMAIN.B62, M1A5D.3 (D), R4D.2
O0: JMAIN.B9, MN0.1 (G), R0.1
O1: JMAIN.B10, MN1.1 (G), R1.1
O2: JMAIN.B11, M2S3D.1 (G), M5S3D.1 (G), R2.1
O3: JMAIN.B12, MS1D.1 (G), R3.1
O4: JMAIN.B13, M1S2D.1 (G), R4.1
O5: JMAIN.B14, M1S4D.1 (G), M2S7D.1 (G), R5.1
O6: JMAIN.B15, M1U1.1 (G), MN3D.1 (G), R6.1
O6#_D: M2S4D.1 (G), MN3D.3 (D), RN3D.1
O7: JMAIN.B16, M2U1.1 (G), M3S4D.1 (G), R7.1
OJump#: M1MAJ.1 (G), M1U2.3 (D), M2S5D.1 (G), RU2.1
OR: JMAIN.B61, M1A4D.3 (D), M2A4D.3 (D), RA4D.1
OUT#: JMAIN.B64, ML1D.3 (D), RL1D.1
P0#_S: M2OL0S.1 (G), MIBF0S.1 (G), MJBF0S.3 (D), Q1BF0S.3, RJBF0S.1
P0_S: MIBF0S.3 (D), MJBF0S.1 (G), MNL1S.2 (S), Q2BF0S.3, RIBF0S.1
P1#_S: M2OL1S.1 (G), MIBF1S.1 (G), MJBF1S.3 (D), MNL0S.2 (S), Q1BF1S.3, RJBF1S.1
P1_S: MIBF1S.3 (D), MJBF1S.1 (G), Q2BF1S.3, RIBF1S.1
PRE: M1MAK.1 (G), MU4.3 (D), RU4.1
Push#: M1S7D.3 (D), M2OU0S.1 (G), M2OU1S.1 (G), MNU0S.1 (G), MNU1S.1 (G), MS8D.1 (G), RS7D.1
Q0#_S: M1DS.1 (G), M1OU1S.1 (G), M3DS.1 (G), MN0S.3 (D), MNU0S.2 (S), RN0S.1
Q0_S: M0DS.1 (G), M2DS.1 (G), ML0S.3 (D), MN0S.1 (G), RL0S.1
Q1#_S: M5DS.1 (G), MN1S.3 (D), MNU1S.2 (S), RN1S.1
Q1_S: M1OU0S.1 (G), M4DS.1 (G), ML1S.3 (D), MN1S.1 (G), RL1S.1
QE: JMAIN.B54, MN6D.3 (D), RN6D.1
Q_A1_D: M1A1D.3 (D), M1N4D.1 (G), M2A1D.3 (D), M2N4D.1 (G), RA1D.1
Q_G: M1G.3 (D), M1H.1 (G), M2G.3 (D), RG.1
Q_H: M1H.3 (D), M1NW0.1 (G), MIW0.2 (S), MW0.3 (D), RH.1
Q_I_P: M1P.1 (G), MIP.3 (D), RIP.2
Q_L6_D: M1L6D.3 (D), M2L4D.2 (S), M2L6D.3 (D)
Q_N5_D: MN5D.3 (D), MN6D.1 (G), RN5D.1
Q_N_L0_S: ML0S.1 (G), MNL0S.3 (D), RNL0S.1
Q_N_L1_S: ML1S.1 (G), MNL1S.3 (D), RNL1S.1
Q_O_L0_S: M1OL0S.3 (D), M2OL0S.3 (D), ML0S.2 (S)
Q_O_L1_S: M1OL1S.3 (D), M2OL1S.3 (D), ML1S.2 (S)
Q_U1: M1U1.3 (D), M2U1.3 (D), M2U2.1 (G), RU1.1
R0_S: M1NAF0S.1 (G), M3OU0S.3 (D), MAF0S.3 (D), MIAF0S.2 (S), ROU0S.1
R1_S: M1NAF1S.1 (G), M3OU1S.3 (D), MAF1S.3 (D), MIAF1S.2 (S), ROU1S.1
RA: JMAIN.B39, M0R.3 (D), R0R.2
RK: JMAIN.B43, M7R.3 (D), R4R.2
RST#: JMAIN.B8, M1MU5.1 (G)
RU: JMAIN.B42, M3R.3 (D), R3R.2
RX: JMAIN.B40, M1R.3 (D), R1R.2
RY: JMAIN.B41, M2R.3 (D), R2R.2
R_C: MIAC.3 (D), MJAC.1 (G), Q1BC.2, RIAC.1
R_F0_S: MIAF0S.1 (G), MJAF0S.3 (D), Q1BF0S.2, RJAF0S.1
R_F1_S: MIAF1S.1 (G), MJAF1S.3 (D), Q1BF1S.2, RJAF1S.1
R_J: MIAJ.3 (D), MJAJ.1 (G), Q1BJ.2, RIAJ.1
R_K: MIAK.3 (D), MJAK.1 (G), Q1BK.2, RIAK.1
Ret: JMAIN.B3, M1OL0S.1 (G), M1OL1S.1 (G), M1S4D.3 (D), M1S6D.1 (G), M2S4D.3 (D), M3S4D.3 (D), M4S4D.3 (D), MNL0S.1 (G), MNL1S.1 (G), R1D.2
S0: D0DS.2, JMAIN.B35, M0DS.3 (D), R0DS.2
S1: D1DS.2, JMAIN.B36, M1DS.3 (D), R1DS.2
S2: D3DS.2, JMAIN.B37, M3DS.3 (D), R3DS.2
S3: D2DS.2, JMAIN.B38, M2DS.3 (D), R2DS.2
S#_P: M1PP.1 (G), M2P.3 (D), M2PP.1 (G), R2P.1
SO#_D: M2L2D.1 (G), ML1D.2 (S), ML3D.3 (D), RL3D.1
S_C: MIAC.1 (G), MJAC.3 (D), Q2BC.2, RJAC.1
S_F0_S: MIAF0S.3 (D), MJAF0S.1 (G), Q2BF0S.2, RIAF0S.1
S_F1_S: MIAF1S.3 (D), MJAF1S.1 (G), Q2BF1S.2, RIAF1S.1
S_J: MIAJ.1 (G), MJAJ.3 (D), Q2BJ.2, RJAJ.1
S_K: MIAK.1 (G), MJAK.3 (D), Q2BK.2, RJAK.1
S_P: M1NP.1 (G), M1P.3 (D), M2NP.1 (G), R1P.1
VPush: JMAIN.B4, MS8D.3 (D), RS8D.2
Vdd: JMAIN.B33, M1BJ.2 (S), M1BK.2 (S), M1P.2 (S), M2N2.2 (S), M2N4D.2 (S), M2N7D.2 (S), M2NP.2 (S), M2P.2 (S), M2PP.2 (S), M3BJ.2 (S), M3BK.2 (S), M3U6.2 (S), MIP.2 (S), R1D.1, R1S3D.2, R1U6.2, R2S3D.2, R3D.2, R4D.1, RA1D.2, RA2D.2, RA4D.2, RA6D.2, RCD.2, RG.2, RH.2, RIAC.2, RIAF0S.2, RIAF1S.2, RIAJ.2, RIAK.2, RIBC.2, RIBF0S.2, RIBF1S.2, RIU5.2, RIW0.2, RIW1.2, RIW2.2, RJAC.2, RJAF0S.2, RJAF1S.2, RJAJ.2, RJAK.2, RJBC.2, RJBF0S.2, RJBF1S.2, RJU5.2, RJW0.2, RJW1.2, RJW2.2, RL0S.2, RL1D.2, RL1S.2, RL2D.2, RL3D.2, RL4D.2, RL7D.2, RL8D.2, RMAC.2, RMAJ.2, RMAK.2, RMU5.2, RMW1.2, RMW2.2, RN0.2, RN0S.2, RN1.2, RN1S.2, RN3D.2, RN5D.2, RN6D.2, RNL0S.2, RNL1S.2, RNU0S.2, RNU1S.2, ROU0S.2, ROU1S.2, RS1D.2, RS5D.2, RS6D.2, RS7D.2, RU1.2, RU3.2, RU4.2, RU7.2
W0: M0W.1 (G), M2W.1 (G), M8W.1 (G), MIW0.1 (G), MJW0.3 (D), RJW0.1
W0#: M1W.1 (G), M3W.1 (G), MIW0.3 (D), MJW0.1 (G), RIW0.1
W1: M4W.1 (G), MIW1.1 (G), MJW1.3 (D), RJW1.1
W1#: M5W.1 (G), MIW1.3 (D), MJW1.1 (G), RIW1.1
W2: M6W.1 (G), MIW2.1 (G), MJW2.3 (D), RJW2.1
W2#: M7W.1 (G), MIW2.3 (D), MJW2.1 (G), RIW2.1
WA: D0W.2, JMAIN.B44, M0W.3 (D), R0W.2
WR: D4W.2, JMAIN.B69, M8W.3 (D), R4W.2
WU: D3W.2, JMAIN.B47, M3W.3 (D), R3W.2
WX: D1W.2, JMAIN.B45, M1W.3 (D), R1W.2
WY: D2W.2, JMAIN.B46, M2W.3 (D), R2W.2
X_A5_D: M1A5D.2 (S), M2A5D.3 (D)
X_A_C: M1NAC.3 (D), M2NAC.3 (D), M3NAC.3 (D), MJAC.2 (S)
X_A_F0_S: M1NAF0S.3 (D), M2NAF0S.3 (D), MJAF0S.2 (S)
X_A_F1_S: M1NAF1S.3 (D), M2NAF1S.3 (D), MJAF1S.2 (S)
X_A_J: M1NAJ.3 (D), M2NAJ.3 (D), MJAJ.2 (S)
X_A_K: M1NAK.3 (D), M2NAK.3 (D), MJAK.2 (S)
X_S3_D: M1S3D.2 (S), M2S3D.3 (D)
X_U5: M1NU5.3 (D), M2NU5.3 (D), MJU5.2 (S)
X_W0: M1NW0.3 (D), M2NW0.3 (D), MJW0.2 (S)
X_W1: M1NW1.3 (D), M2NW1.3 (D), MJW1.2 (S)
X_W2: M1NW2.3 (D), M2NW2.3 (D), MJW2.2 (S)
Y_A5_D: M2A5D.2 (S), M3A5D.3 (D)
Y_S3_D: M1S3D.3 (D), M3S3D.1 (G), R1S3D.1
Z: JMAIN.B6, MS1D.2 (S)
Z_S3_D: M3S3D.2 (S), M4S3D.3 (D), M5S3D.3 (D)
_co1_D: M2D.2 (S), M3D.3 (D), M6D.3 (D)
_co2_D: M9D.2 (S), M10D.3 (D)
_co3_D: M8D.2 (S), M9D.3 (D)
_co4_D: M3D.2 (S), M4D.3 (D)
_co6_D: M4D.2 (S), M5D.3 (D), M6D.2 (S), M7D.3 (D)
g#_B_J: M1BJ.1 (G), M2BJ.1 (G), Q1BJ.3, R2BJ.1
g#_B_K: M1BK.1 (G), M2BK.1 (G), Q1BK.3, R2BK.1
g_B_J: M3BJ.1 (G), M4BJ.1 (G), Q2BJ.3, R1BJ.2
g_B_K: M3BK.1 (G), M4BK.1 (G), Q2BK.3, R1BK.2
g_U6: M1U6.1 (G), Q1U6.3, R2U6.1
iRST: M1U6.3 (D), M2U6.1 (G), M3U6.1 (G), Q2U6.3, R1U6.1
iRST#: M2U6.3 (D), M3U6.3 (D), R0.2, R1.2, R2.2, R2U6.2, R3.2, R4.2, R5.2, R6.2, R7.2, RU2.2
lR: MIU5.3 (D), MJU5.1 (G), Q2U6.2, RIU5.1
lR#: MIU5.1 (G), MJU5.3 (D), Q1U6.2, RJU5.1
phi: D0W.1, D1W.1, D2W.1, D3W.1, D4W.1, JMAIN.B48, M1N2.1 (G), M1PP.3 (D), M2MAC.1 (G), M2MAJ.1 (G), M2MAK.1 (G), M2MU5.1 (G), M2MW1.1 (G), M2MW2.1 (G), M2N2.1 (G), M2NAC.1 (G), M2NAF0S.1 (G), M2NAF1S.1 (G), M2NAJ.1 (G), M2NAK.1 (G), M2NU5.1 (G), M2NW0.1 (G), M2NW1.1 (G), M2NW2.1 (G), M2PP.3 (D), M6W.2 (S), M7W.2 (S), MAF0S.1 (G), MAF1S.1 (G), MW0.1 (G), Q1BC.1, Q1BF0S.1, Q1BF1S.1, Q1BJ.1, Q1BK.1, Q1U6.1, Q2BC.1, Q2BF0S.1, Q2BF1S.1, Q2BJ.1, Q2BK.1, Q2U6.1, R1P.2
phi1: JMAIN.B50, M1NP.3 (D), M2NP.3 (D), MS8D.2 (S), R2P.2
phi#: D0DS.1, D1DS.1, D2DS.1, D3DS.1, M1N2.3 (D), M2N2.3 (D), M4DS.2 (S), M5DS.2 (S)
t_W: M0W.2 (S), M1W.2 (S), M4W.3 (D)
unnamed_net1: D1.1, R8.2
unnamed_net2: D2.1, R9.2
v_W: M2W.2 (S), M3W.2 (S), M5W.3 (D)
w2n: M1G.2 (S), M1MW2.1 (G), M2G.2 (S), M3U7.3 (D), RU7.1
w_W: M4W.2 (S), M5W.2 (S), M6W.3 (D)
x_A6_D: M1A6D.2 (S), M2A6D.3 (D)
x_D_S: M0DS.2 (S), M1DS.2 (S), M4DS.3 (D)
x_H: M1H.2 (S), M2H.3 (D)
x_L4_D: M1L4D.2 (S), M2L4D.3 (D)
x_L5_D: M1L5D.2 (S), M2L5D.3 (D)
x_O_U0_S: M1OU0S.3 (D), M2OU0S.3 (D), M3OU0S.2 (S)
x_O_U1_S: M1OU1S.3 (D), M2OU1S.3 (D), M3OU1S.2 (S)
x_R: M0R.2 (S), M1R.2 (S), M4R.3 (D)
x_S2_D: M1S2D.2 (S), M2S2D.3 (D)
x_S7_D: M1S7D.2 (S), M2S7D.3 (D)
x_U0_S: M3OU0S.1 (G), MNU0S.3 (D), RNU0S.1
x_U1_S: M3OU1S.1 (G), MNU1S.3 (D), RNU1S.1
x_U2: M1U2.2 (S), M2U2.3 (D)
x_U7: M1U7.3 (D), M2U7.3 (D), M3U7.2 (S)
y_D_S: M2DS.2 (S), M3DS.2 (S), M5DS.3 (D)
y_R: M2R.2 (S), M3R.2 (S), M5R.3 (D)
z_R: M4R.2 (S), M5R.2 (S), M6R.3 (D)
z_W: M7W.3 (D), M8W.2 (S)
ϕin: JMAIN.B5, M2P.1 (G), MIP.1 (G)
