rcls/discus/bit-board.kicad_pcb

## KiCad design bit-board.kicad_pcb (2026-03-17)

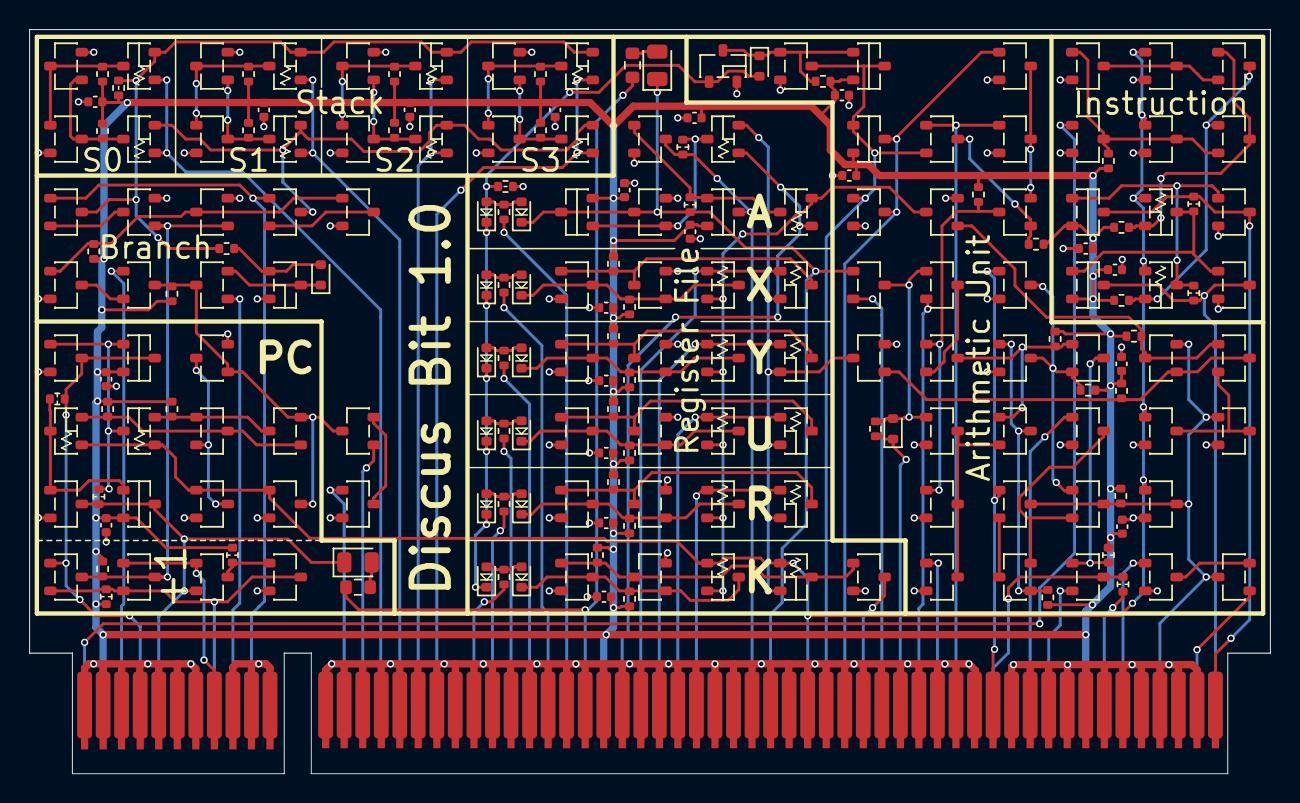
[picture p67: board bit-board.kicad_pcb from above]

Board: 4 copper layers, 85.0 x 51.0 mm, 209 parts (0 on the bottom side), 120 nets.

Parts:
C1, C2, C3, C4, C5, C6, C7, C8, C9, C10, C11, C12, C13, C14, C15, C16, C17, C18, C19, C20: 0.1u; C_0402
D1, D4, D5: RB751S40; SOD523
D1A, D1K, D1R, D1U, D1X, D1Y, D2A, D2K, D2R, D2U, D2X, D2Y: 1N4148WT; SOD523-diode
D2: ledgreen; 0805-diode
D3: ledred; 0805-diode
JMAIN: unknown; pci-edge-3v
M1, M1B2, M1B3, M1DE, M1L0, M1L1, M1L2, M1L3, M1MAG, M1NAF, M1NAG, M1NEE, M1NL, M1NS4, M1OEE, M1ON, M1S5, M1S6, M1S7, M1S8, M1S9, M1XE, M2, M2A, M2BF, M2BG, M2DE, M2L0, M2L1, M2L2, M2L3, M2MAG, M2NAF, M2NAG, M2NEE, M2NL, M2NS4, M2OEE, M2ON, M2S5, M2S6, M2S7, M2S8, M2S9, M2XE, M3, M3OEE, M3ON, M3XE, M4, M4A, M4BF, M4BG, M4XE: FDV301N; SOT23_nmos
M1A, M1BF, M1BG, M2B2, M2B3, M3A, M3BF, M3BG: NX3008PBK; SOT23_pmos
MAF: FDV301N; SOT23_nmos
ME: FDV301N; SOT23_nmos
MI3, MI5: FDV301N; SOT23_nmos
MIAF: FDV301N; SOT23_nmos
MIAG: FDV301N; SOT23_nmos
MIE: FDV301N; SOT23_nmos
MIK: FDV301N; SOT23_nmos
MIL: FDV301N; SOT23_nmos
MIR: FDV301N; SOT23_nmos
MIS4: FDV301N; SOT23_nmos
MIU: FDV301N; SOT23_nmos
MIX: FDV301N; SOT23_nmos
MIY: FDV301N; SOT23_nmos
MJAF: FDV301N; SOT23_nmos
MJAG: FDV301N; SOT23_nmos
MJK: FDV301N; SOT23_nmos
MJL: FDV301N; SOT23_nmos
MJR: FDV301N; SOT23_nmos
MJU: FDV301N; SOT23_nmos
MJX: FDV301N; SOT23_nmos
MJY: FDV301N; SOT23_nmos
ML: FDV301N; SOT23_nmos
MNN: FDV301N; SOT23_nmos
MPE: FDV301N; SOT23_nmos
MPS4: FDV301N; SOT23_nmos
Q1BF, Q1BG, Q1K, Q1L0, Q1L1, Q1L2, Q1L3, Q1R, Q1U, Q1X, Q1Y, Q2A, Q2BF, Q2BG, Q2K, Q2L0, Q2L1, Q2L2, Q2L3, Q2R, Q2U, Q2X, Q2Y, Q3A: PDTC124TU; SOT23_bias
Q3: BC847BW; SOT23_bjt
QI4: BC847BW; SOT23_bjt
R1: 10k; R_0402_pull
R1A, R1BF, R1BG, R2A, R2BF, R2BG: 820; R_0402_strong
R1K, R1L0, R1L1, R1L2, R1L3, R1R, R1U, R1X, R1Y, R2L0, R2L1, R2L2, R2L3, R3A, R6: 2k49; R_0402_load
R2: 47k; R_0402_pull
R4, R5: 1k5; 0603
RDE: 2k49; R_0402_load
RI3, RI4, RI5: 2k49; R_0402_load
RIAF: 2k49; R_0402_load
RIAG: 2k49; R_0402_load
RIE: 820; R_0402_strong
RIK: 2k49; R_0402_load
RIL: 2k49; R_0402_load
RIR: 2k49; R_0402_load
RIS4: 820; R_0402_strong
RIU: 2k49; R_0402_load
RIX: 2k49; R_0402_load
RIY: 2k49; R_0402_load
RJAF: 2k49; R_0402_load
RJAG: 2k49; R_0402_load
RJK: 2k49; R_0402_load
RJL: 2k49; R_0402_load
RJR: 2k49; R_0402_load
RJU: 2k49; R_0402_load
RJX: 2k49; R_0402_load
RJY: 2k49; R_0402_load
RMAG: 2k49; R_0402_load
RNEE: 2k49; R_0402_load
RNN: 2k49; R_0402_load
RNS4: 2k49; R_0402_load
ROEE: 2k49; R_0402_load
RON: 2k49; R_0402_load
RPE: 820; R_0402_strong
RPS4: 820; R_0402_strong
RS6: 2k49; R_0402_load
RXE: 2k49; R_0402_load

Connections:
AND: JMAIN.A47, M4XE.1 (G)
AR#: D1.1, JMAIN.A45, RI5.2
AS: JMAIN.A44, MI5.2 (S)
Ao: JMAIN.A37, M3A.3 (D), M4A.3 (D), R2A.2
Ao#: D2.1, D2A.1, JMAIN.A38, M1A.3 (D), M2A.3 (D), MI5.1 (G), R1A.1
B: JMAIN.A42, M1B3.3 (D), M1ON.1 (G), M2B3.3 (D)
B#: JMAIN.A41, M1B2.3 (D), M1B3.1 (G), M2B2.3 (D), M2B3.1 (G), MNN.2 (S)
Bi: D4.1, M1B2.1 (G), M2B2.1 (G), QI4.3, RI4.1
Bi#: D1A.1, D1K.1, D1R.1, D1U.1, D1X.1, D1Y.1, D4.2, QI4.1, R1.2
Bling: JMAIN.A28, R4.2, R5.2
C2_E: M1NEE.3 (D), M2NEE.3 (D), M2OEE.1 (G), MIE.2 (S), RNEE.1
CON: JMAIN.A57, M2S8.1 (G)
CR: JMAIN.A53, MPE.2 (S)
CS#: JMAIN.A56, RPE.2
Ci#: JMAIN.B50, M1OEE.1 (G), M2NEE.1 (G)
Co#: JMAIN.A50, MPE.3 (D), RPE.1
D#_A_G: M1MAG.3 (D), M1NAG.1 (G), M2MAG.3 (D), MIAG.2 (S), RMAG.1
EA: D1.2, M2DE.1 (G), M2XE.1 (G), MI5.3 (D), RI5.1
EB: M1DE.1 (G), M3ON.3 (D), M3XE.1 (G), RON.1
GND: C1.1, C2.1, C3.1, C4.1, C5.1, C6.1, C7.1, C8.1, C9.1, C10.1, C11.1, C12.1, C13.1, C14.1, C15.1, C16.1, C17.1, C18.1, C19.1, C20.1, JMAIN.B1, JMAIN.B2, JMAIN.B3, JMAIN.B4, JMAIN.B5, JMAIN.B6, JMAIN.B7, JMAIN.B9, JMAIN.B10, JMAIN.B11, JMAIN.B14, JMAIN.B15, JMAIN.B16, JMAIN.B17, JMAIN.B18, JMAIN.B19, JMAIN.B20, JMAIN.B21, JMAIN.B22, JMAIN.B23, JMAIN.B24, JMAIN.B25, JMAIN.B26, JMAIN.B27, JMAIN.B28, JMAIN.B29, JMAIN.B30, JMAIN.B31, JMAIN.B32, JMAIN.B33, JMAIN.B34, JMAIN.B35, JMAIN.B36, JMAIN.B37, JMAIN.B38, JMAIN.B39, JMAIN.B40, JMAIN.B41, JMAIN.B42, JMAIN.B43, JMAIN.B44, JMAIN.B45, JMAIN.B46, JMAIN.B47, JMAIN.B48, JMAIN.B49, JMAIN.B51, JMAIN.B52, JMAIN.B53, JMAIN.B54, JMAIN.B55, JMAIN.B56, JMAIN.B57, JMAIN.B58, JMAIN.B59, JMAIN.B60, JMAIN.B61, M1B2.2 (S), M1B3.2 (S), M1L0.2 (S), M1L1.2 (S), M1L2.2 (S), M1L3.2 (S), M1MAG.2 (S), M1NAF.2 (S), M1NAG.2 (S), M1NEE.2 (S), M1NL.2 (S), M1ON.2 (S), M2.2 (S), M2A.2 (S), M2BF.2 (S), M2BG.2 (S), M2L0.2 (S), M2L1.2 (S), M2L2.2 (S), M2L3.2 (S), M2MAG.2 (S), M2NAF.2 (S), M2NAG.2 (S), M2NEE.2 (S), M2NL.2 (S), M2ON.2 (S), M2S5.2 (S), M2S6.2 (S), M2S7.2 (S), M2S8.2 (S), M2S9.2 (S), M2XE.2 (S), M3.2 (S), M3XE.2 (S), M4.2 (S), M4A.2 (S), M4BF.2 (S), M4BG.2 (S), M4XE.2 (S), MAF.2 (S), ME.2 (S), MI3.2 (S), MIK.2 (S), MIR.2 (S), MIU.2 (S), MIX.2 (S), MIY.2 (S), MJK.2 (S), MJR.2 (S), MJU.2 (S), MJX.2 (S), MJY.2 (S), ML.2 (S), MPS4.2 (S), Q3.2, QI4.2, R1.1
I: JMAIN.A62, M1BG.3 (D), M2BG.3 (D), R1BG.1
I#: JMAIN.B62, M3BG.3 (D), M4BG.3 (D), R2BG.2
Inc: JMAIN.A3, M1S6.1 (G)
J: JMAIN.A16, M1S7.1 (G)
Jump: JMAIN.A15, M2S7.1 (G)
K: M4.1 (G), MIK.1 (G), MJK.3 (D), Q2K.3, RJK.1
K#: JMAIN.A61, M1S8.1 (G)
L_K: D2K.1, MIK.3 (D), MJK.1 (G), Q1K.3, RIK.1
L_L0: M1L0.3 (D), M2L0.1 (G), Q1L0.3, R1L0.1
L_L1: M1L1.3 (D), M2L1.1 (G), Q1L1.3, R1L1.1
L_L2: M1L2.3 (D), M2L2.1 (G), Q1L2.3, R1L2.1
L_L3: M1L3.3 (D), M2L3.1 (G), Q1L3.3, R1L3.1
L_R: D2R.1, MIR.3 (D), MJR.1 (G), Q1R.3, RIR.1
L_U: D2U.1, MIU.3 (D), MJU.1 (G), Q1U.3, RIU.1
L_X: D2X.1, MIX.3 (D), MJX.1 (G), Q1X.3, RIX.1
L_Y: D2Y.1, MIY.3 (D), MJY.1 (G), Q1Y.3, RIY.1
N#: JMAIN.A48, M2ON.1 (G), MNN.1 (G)
O: JMAIN.A1, M1MAG.1 (G)
OR: JMAIN.A46, M2DE.2 (S)
P: JMAIN.A4, M1NS4.1 (G), M3BF.3 (D), M4BF.3 (D), R2BF.2
P#: D3.1, JMAIN.A5, M1BF.3 (D), M2BF.3 (D), MIS4.2 (S), R1BF.1
PCi: JMAIN.B8, M2NS4.1 (G), MIS4.1 (G)
PCo: JMAIN.A8, M1NS4.2 (S), M2NS4.2 (S), MPS4.3 (D), RPS4.1
Pn#: M1.3 (D), M1NAF.1 (G), M1S6.3 (D), M1S7.3 (D), MAF.3 (D), MIAF.2 (S), RS6.1
Pp: M2S6.1 (G), M2S9.1 (G), MI3.3 (D), RI3.1
Pp#: M1NS4.3 (D), M2NS4.3 (D), M2S5.1 (G), MI3.1 (G), RNS4.1
Q: JMAIN.A59, M1NL.1 (G), M1OEE.3 (D), M1S8.3 (D), M2OEE.3 (D), MIL.2 (S), ML.3 (D), ROEE.1
QE: JMAIN.A52, ME.1 (G)
Q_D_E: M1DE.3 (D), M1XE.1 (G), MIE.1 (G), RDE.1
Q_I_E: MIE.3 (D), MPE.1 (G), RIE.1
Q_I_S4: MIS4.3 (D), MPS4.1 (G), RIS4.1
Q_X_E: M1NEE.1 (G), M1XE.3 (D), M3OEE.1 (G), RXE.1
RA: JMAIN.A27, R3A.1
RK: JMAIN.A22, R1K.1
RR: JMAIN.A23, R1R.1
RU: JMAIN.A24, R1U.1
RX: JMAIN.A26, R1X.1
RY: JMAIN.A25, R1Y.1
R_F: MIAF.1 (G), MJAF.3 (D), Q1BF.2, RJAF.1
R_G: MIAG.3 (D), MJAG.1 (G), Q1BG.2, RIAG.1
R_L0: M1L0.1 (G), M2L0.3 (D), Q2L0.3, R2L0.1
R_L1: M1L1.1 (G), M2L1.3 (D), Q2L1.3, R2L1.1
R_L2: M1L2.1 (G), M2L2.3 (D), Q2L2.3, R2L2.1
R_L3: M1L3.1 (G), M2L3.3 (D), Q2L3.3, R2L3.1
R_R: MIR.1 (G), MJR.3 (D), Q2R.3, RJR.1
R_U: MIU.1 (G), MJU.3 (D), Q2U.3, RJU.1
R_X: MIX.1 (G), MJX.3 (D), Q2X.3, RJX.1
R_Y: MIY.1 (G), MJY.3 (D), Q2Y.3, RJY.1
Ret: JMAIN.A9, M1.1 (G)
S0: JMAIN.A17, Q1L0.1, Q2L0.1
S1: JMAIN.A18, Q1L1.1, Q2L1.1
S2: JMAIN.A19, Q1L2.1, Q2L2.1
S3: JMAIN.A20, Q1L3.1, Q2L3.1
SB: M1S5.3 (D), Q1L0.2, Q1L1.2, Q1L2.2, Q1L3.2, R2.1, R6.2
SB#: M1S9.3 (D), Q2L0.2, Q2L1.2, Q2L2.2, Q2L3.2
S_F: MIAF.3 (D), MJAF.1 (G), Q2BF.2, RIAF.1
S_G: MIAG.1 (G), MJAG.3 (D), Q2BG.2, RJAG.1
VPush: JMAIN.A10, M1S5.1 (G), M1S9.1 (G)
Vdd: C1.2, C2.2, C3.2, C4.2, C5.2, C6.2, C7.2, C8.2, C9.2, C10.2, C11.2, C12.2, C13.2, C14.2, C15.2, C16.2, C17.2, C18.2, C19.2, C20.2, JMAIN.A2, JMAIN.A29, JMAIN.A55, M1A.2 (S), M1BF.2 (S), M1BG.2 (S), M2B2.2 (S), M2B3.2 (S), M3A.2 (S), M3BF.2 (S), M3BG.2 (S), R1L0.2, R1L1.2, R1L2.2, R1L3.2, R2.2, R2L0.2, R2L1.2, R2L2.2, R2L3.2, RDE.2, RI3.2, RI4.2, RIAF.2, RIAG.2, RIE.2, RIK.2, RIL.2, RIR.2, RIS4.2, RIU.2, RIX.2, RIY.2, RJAF.2, RJAG.2, RJK.2, RJL.2, RJR.2, RJU.2, RJX.2, RJY.2, RMAG.2, RNEE.2, RNN.2, RNS4.2, ROEE.2, RON.2, RPS4.2, RS6.2, RXE.2
W: M3.3 (D), Q2A.2, Q2K.2, Q2R.2, Q2U.2, Q2X.2, Q2Y.2
W#: M2.3 (D), Q1K.2, Q1R.2, Q1U.2, Q1X.2, Q1Y.2, Q3A.2
WA: JMAIN.A30, Q2A.1, Q3A.1
WR: JMAIN.A34, Q1R.1, Q2R.1
WU: JMAIN.A33, Q1U.1, Q2U.1
WX: JMAIN.A31, Q1X.1, Q2X.1
WY: JMAIN.A32, Q1Y.1, Q2Y.1
Wg: M2.1 (G), MIL.3 (D), MJL.1 (G), RIL.1
Wg#: M3.1 (G), MIL.1 (G), MJL.3 (D), RJL.1
X_A_F: M1NAF.3 (D), M2NAF.3 (D), MJAF.2 (S)
X_A_G: M1NAG.3 (D), M2NAG.3 (D), MJAG.2 (S)
X_L: M1NL.3 (D), M2NL.3 (D), MJL.2 (S)
Z: JMAIN.A43, M4.3 (D)
_d2: D2.2, R4.1
_d3: D3.2, R5.1
_sb: D5.2, Q3.1, R6.1
_sb#: D5.1, M1.2 (S), Q3.3
br_A: D1A.2, D2A.2, R3A.2
br_K: D1K.2, D2K.2, R1K.2
br_R: D1R.2, D2R.2, R1R.2
br_U: D1U.2, D2U.2, R1U.2
br_X: D1X.2, D2X.2, R1X.2
br_Y: D1Y.2, D2Y.2, R1Y.2
g#_B_F: M1BF.1 (G), M2BF.1 (G), Q1BF.3, R2BF.1
g#_B_G: M1BG.1 (G), M2BG.1 (G), Q1BG.3, R2BG.1
g_B_F: M3BF.1 (G), M4BF.1 (G), Q2BF.3, R1BF.2
g_B_G: M3BG.1 (G), M4BG.1 (G), Q2BG.3, R1BG.2
gl_A: M3A.1 (G), M4A.1 (G), Q3A.3, R1A.2
gr_A: M1A.1 (G), M2A.1 (G), Q2A.3, R2A.1
m_O_E_E: M1OEE.2 (S), M3OEE.3 (D)
phi: JMAIN.A40, M2MAG.1 (G), M2NAF.1 (G), M2NAG.1 (G), M2NL.1 (G), MAF.1 (G), ML.1 (G), Q1BF.1, Q1BG.1, Q1K.1, Q2BF.1, Q2BG.1, Q2K.1
qg_E: M2OEE.2 (S), M3OEE.2 (S), ME.3 (D)
r_X_E: M1XE.2 (S), M2XE.3 (D), M3XE.3 (D), M4XE.3 (D)
x_D_E: M1DE.2 (S), M2DE.3 (D)
x_N: M3ON.1 (G), MNN.3 (D), RNN.1
x_O_N: M1ON.3 (D), M2ON.3 (D), M3ON.2 (S)
x_S5: M1S5.2 (S), M2S5.3 (D)
x_S6: M1S6.2 (S), M2S6.3 (D)
x_S7: M1S7.2 (S), M2S7.3 (D)
x_S8: M1S8.2 (S), M2S8.3 (D)
x_S9: M1S9.2 (S), M2S9.3 (D)
