rcls/discus/src/instructions.rs

use Condition::*;
use Instruction::*;
use Register::*;
use Value::*;

// Convenience for "use instructions.constants.*;" without undue pollution.
pub mod constants {
    pub use super::Condition::*;
    pub use super::Input::*;
    pub use super::Register::*;
}

#[derive(Clone, Copy, Debug, PartialEq, Eq)]
pub enum Register {A, X, Y, U}

#[derive(Clone, Copy, Debug, PartialEq, Eq)]
pub enum Input {IN}

#[derive(Clone, Copy, Debug, PartialEq, Eq)]
pub enum Value {
    Reg(Register),
    Num(u8),
    MemReg(Register),
    MemNum(u8),
    Input,
}

#[derive(Clone, Debug, PartialEq, Eq)]
pub enum Target {
    Label(String),
    Addr(u8),
}

pub enum Condition {
    Always = 0, Never = 4, Z = 8, NZ = 12, C = 16, NC = 20,
    _CZ = 24, _NCZ = 28,
}

const STA  : u8 = 0x68;
const INP  : u8 = 0x70;
const MEM  : u8 = 0x7c;
const LOAD : u8 = 0xc8;
const LOADM: u8 = 0xcc;

#[derive(Clone, Debug, PartialEq)]
pub enum Instruction {
    Byte(u8),
    Address(Target),
}

type Check = Box<dyn Fn(&crate::state::State) -> bool>;

#[derive(Default)]
pub struct Instructions {
    pub insns: Vec<Instruction>,
    pub labels: std::collections::BTreeMap<String, u8>,
    pub checks: std::collections::BTreeMap<u8, Check>,
}

impl From<u8> for Value {fn from(v: u8) -> Value {Num(v)}}

impl From<Register> for Value {fn from(r: Register) -> Value {Reg(r)}}

impl From<[u8; 1]> for Value {fn from([n]: [u8; 1]) -> Value {MemNum(n)}}

impl From<[Register; 1]> for Value {
    fn from([r]: [Register; 1]) -> Value {MemReg(r)}
}

impl From<Input> for Value {
    fn from(_: Input) -> Value {Input}
}

impl From<u8> for Target { fn from(a: u8) -> Target {Target::Addr(a)} }

impl From<String> for Target {
    fn from(l: String) -> Target {Target::Label(l)}
}

impl From<&str> for Target {
    fn from(l: &str) -> Target { Target::Label(l.to_string()) }
}

impl Instructions {
    pub fn assemble(&self) -> Vec<u8> {
        let mut r = Vec::default();
        let mut address: u8 = 0;
        for insn in &self.insns {
            let (b, a) = match insn {
                Address(Target::Addr(a)) => (a & 0x3f, a >> 6),
                Address(Target::Label(l)) => {
                    let a = self.labels.get(l).expect(l);
                    (a & 0x3f, a >> 6)
                }
                Byte(b) => (b + address, 0),
            };
            address = a;
            r.push(b);
        }
        r
    }

    fn insn(&mut self, insn: Instruction) -> &mut Self {
        self.insns.push(insn);
        self
    }

    pub fn label(&mut self, l: impl Into<String>) -> &mut Self {
        assert!(self.insns.len() < 256);
        self.labels.insert(l.into(), self.insns.len().try_into().unwrap());
        self
    }

    pub fn byte(&mut self, b: u8) -> &mut Self { self.insn(Byte(b)) }
    fn code(&mut self, b: u8, v: impl Into<Value>) -> &mut Self {
        match v.into() {
            Reg   (r) => self.byte(b + r as u8),
            Num   (n) => self.byte(n & 0x3f).byte(b + (n >> 6)),
            MemReg(r) => self.byte(MEM + r as u8).byte(b),
            MemNum(n) => self.byte(n & 0x3f).byte(MEM + (n >> 6)).byte(b),
            Input     => self.byte(INP).byte(b),
        }
    }

    pub fn mem(&mut self, v: impl Into<Value>) -> &mut Self {self.code(MEM, v)}
    pub fn add(&mut self, v: impl Into<Value>) -> &mut Self {self.code(0x80, v)}
    pub fn sub(&mut self, v: impl Into<Value>) -> &mut Self {self.code(0x84, v)}
    pub fn or (&mut self, v: impl Into<Value>) -> &mut Self {self.code(0x88, v)}
    pub fn and(&mut self, v: impl Into<Value>) -> &mut Self {self.code(0x8c, v)}
    pub fn adc(&mut self, v: impl Into<Value>) -> &mut Self {self.code(0x90, v)}
    pub fn sbc(&mut self, v: impl Into<Value>) -> &mut Self {self.code(0x94, v)}
    pub fn xor(&mut self, v: impl Into<Value>) -> &mut Self {self.code(0x98, v)}
    pub fn cmp(&mut self, v: impl Into<Value>) -> &mut Self {self.code(0xa4, v)}
    pub fn tst(&mut self, v: impl Into<Value>) -> &mut Self {self.code(0xac, v)}
    pub fn sta(&mut self, v: impl Into<Value>) -> &mut Self {self.code(STA, v)}

    pub fn jp(&mut self, cc: Condition, t: impl Into<Target>) -> &mut Self {
        self.insn(Address(t.into())).byte(cc as u8)
    }

    pub fn jump(&mut self, t: impl Into<Target>) -> &mut Self {
        self.jp(Always, t)
    }

    pub fn cl(&mut self, cc: Condition, t: impl Into<Target>) -> &mut Self {
        self.insn(Address(t.into())).byte(0x20 + cc as u8)
    }

    pub fn call(&mut self, t: impl Into<Target>) -> &mut Self {
        self.cl(Always, t)
    }

    pub fn rt(&mut self, cc: Condition) -> &mut Self {
        self.byte(0x40 + cc as u8)
    }
    pub fn ret(&mut self) -> &mut Self { self.rt(Always) }

    pub fn inc(&mut self, r: Register) -> &mut Self { self.incv(r, r) }
    pub fn dec(&mut self, r: Register) -> &mut Self { self.decv(r, r) }

    pub fn incv(&mut self, r: Register, v: impl Into<Value>) -> &mut Self {
        self.code(0xc0 as u8 + r as u8 * 16, v)
    }
    pub fn decv(&mut self, r: Register, v: impl Into<Value>) -> &mut Self {
        self.code(0xc4 as u8 + r as u8 * 16, v)
    }

    pub fn load(&mut self, d: Register, v: impl Into<Value>) -> &mut Self {
        match v.into() {
            Reg   (r) => self.code(LOAD  + d as u8 * 16, r),
            Num   (n) => self.code(LOAD  + d as u8 * 16, n),
            MemReg(r) => self.code(LOADM + d as u8 * 16, r),
            MemNum(n) => self.code(LOADM + d as u8 * 16, n),
            Input     => self.code(LOAD  + d as u8 * 16, Input),
        }
    }

    pub fn out(&mut self) -> &mut Self {self.byte(0x60)}
    #[allow(unused)]
    pub fn inp(&mut self) -> &mut Self {self.byte(INP)}

    /// Set carry.
    pub fn setc(&mut self) -> &mut Self {self.and(A)}
    /// Clear carry.
    pub fn clrc(&mut self) -> &mut Self {self.or(A)}

    pub fn check(&mut self, c: impl 'static + Fn(&crate::state::State) -> bool)
                -> &mut Self {
        self.checks.insert(self.insns.len() as u8, Box::new(c));
        self
    }
}

#[test]
fn test_basic() {
    let mut i = Instructions::default();
    i.add(24).sub(Y).adc([0x9b]).sbc([U]);
    assert_eq!(i.insns.len(), 8);

    let c = i.assemble();
    assert_eq!(c.len(), 8);
    assert_eq!(c[0], 24);
    assert_eq!(c[1], 0x80);
    assert_eq!(c[2], 0x86);
    assert_eq!(c[3], 0x1b);
    assert_eq!(c[4], 0x7e);
    assert_eq!(c[5], 0x90);
    assert_eq!(c[6], 0x7f);
    assert_eq!(c[7], 0x94);
}

#[test]
fn test_parse_jump() {
    let mut i = Instructions::default();
    i.call("foo")
     .label("foo")
     .ret();
    assert_eq!(i.insns.len(), 3);
    assert_eq!(i.labels.len(), 1);
    assert_eq!(i.labels["foo"], 2);
    assert_eq!(i.insns[0], Address(Target::Label("foo".into())));

    let c = i.assemble();
    assert_eq!(c.len(), 3);
    assert_eq!(c[0], 2);
    assert_eq!(c[1], 0x20);
    assert_eq!(c[2], 0x40);
}
