rcls/discus/src/spice_check.rs

use std::fmt::Display;

use crate::{state::State, spice_read::SpiceRead};

pub struct SpiceCheck<'a> {
    success: bool,
    program: &'a [u8],
    spice: &'a SpiceRead,
    state: State,
}

impl SpiceCheck<'_> {
    pub fn new<'a>(program: &'a [u8], spice: &'a SpiceRead) -> SpiceCheck<'a> {
        SpiceCheck{success: true, program, spice, state: State::default()}
    }

    pub fn spice_check(&mut self) {
        let a  = self.spice.extract_byte_diff("a");
        let b  = self.spice.extract_byte_diff("b");
        let x  = self.spice.extract_byte("r_x_b", "l_x_b");
        let y  = self.spice.extract_byte("r_y_b", "l_y_b");
        let u  = self.spice.extract_byte("r_u_b", "l_u_b");
        let r  = self.spice.extract_byte("r_r_b", "l_r_b");
        let k  = self.spice.extract_byte("k_b", "l_k_b");
        let pc = self.spice.extract_byte_diff("p");
        let ins = self.spice.extract_byte_diff("i");
        let c  = self.spice.extract_signal("co_c");
        let stack = [
            self.spice.extract_byte_other("l_l0_b", "r_l0_b"),
            self.spice.extract_byte_other("l_l1_b", "r_l1_b"),
            self.spice.extract_byte_other("l_l2_b", "r_l2_b"),
            self.spice.extract_byte_other("l_l3_b", "r_l3_b")];

        let timestamps: Vec<_> = self.spice.extract_sample("time");

        // Load the state from index 3.
        self.state.a = a[3];
        self.state.x = x[3];
        self.state.y = y[3];
        self.state.u = u[3];
        self.state.c = c[3];
        self.state.k = k[3];
        self.state.r = r[3];
        assert_eq!(pc[2], 0, "PC@2 = {}", pc[2]);
        assert_eq!(pc[3], 1, "PC@3 = {}", pc[3]);

        for i in 4 .. self.spice.num_samples() {
            let this_pc = self.state.pc;

            self.state.step(self.program);

            println!("Timestamp {}µs {} clocks, PC {this_pc:#04x}",
                     timestamps[i] * 1e6, timestamps[i] / self.spice.quantum);
            self.verify(self.state.a, a[i], "A");
            self.verify(self.state.x, x[i], "X");
            self.verify(self.state.y, y[i], "Y");
            self.verify(self.state.u, u[i], "U");
            self.verify(self.state.r, r[i], "R");

            self.verify(self.state.k, k[i], "K");

            self.verify(self.state.c, c[i], "C");

            self.verify(self.state.b, b[i-1], "B");

            self.verify(self.program[self.state.pc as usize], ins[i], "I");

            // The electronics has the instruction unit one cycle ahead of the
            // execute unit, so the PC we want to check is the previous one.
            self.verify(self.state.pc, pc[i - 1], "PC");
            if self.state.pc != pc[i - 1] {
                panic!();
            }

            // Check for stack changes...
            let s_change = stack.iter().filter(|s| s[i-2] != s[i-1]).count();
            if self.state.took_call {
                assert!(s_change <= 1, "Took call, changes {s_change}!");
            }
            else {
                assert_eq!(s_change, 0, "No call, but changes {s_change}!");
            }
        }
        // Sanity check that we've run the correct number of instructions.  The
        // stack should be empty and the current instruction should be an
        // unconditional return (0x40).
        assert_eq!(self.state.sp, 0);
        assert_eq!(self.program[self.state.pc as usize], 0x40);
        assert!(self.success);
    }

    fn verify<T>(&mut self, sim: T, spice: T, what: &str)
                 where T: PartialEq<T> + Display {
        if sim != spice {
            println!("Mismatch @{:#04x} sim {sim} v. spice {spice} on {what}",
                     self.state.pc);
            self.success = false;
        }
    }
}
