rcls/discus/(commit log)

2013-10-18 Playing with spice
    [test.sch]
2013-10-18 Some very basic models working, NPN not doing quite what I want...
    [full.sch, fulli.sch, test.sch]
2013-10-18 Fix the base resistance on the npn.
2013-10-18 Rearrange so we can observe better in simulation.
    [test.sch]
2013-10-18 Trying with spice subckts ... works with a bit of effort.
    [sramcell.sch]
2013-10-18 gschem hierarchies are smoother....
    [sramcell.sch]
2013-10-18 Use i/o connects without netnames
    [sramcell.sch, test.sch]
2013-10-19 Explicit GND & power pins.
    [sramcell.sch, test.sch]
2013-10-19 Basic edge-triggered flip flop
    [flipflop.sch]
2013-10-20 Two phase clock driver, complex version
    [clockdrive.sch, testclockdrive.sch]
2013-10-20 Use nmos not pmos here.
    [clockdrive.sch]
2013-10-20 Simulate faster.
    [testclockdrive.sch]
2013-10-21 Add resistor values to inc*.
    [incnp.sch, incpn.sch]
2013-10-21 Correct file names.
    [clockdrive.sch]
2013-10-21 Fix pin numbers.
2013-10-22 The sram cells don't work for flipflops... fully nmos instead.
    [flipflop.sch]
2013-10-23 Four bit counter using half adders and D flipflops.
    [dflipflop.sch, incnx.sch, testcounter.sch]
2013-10-23 Use jk/t flip-flops instead of d
    [jkflipflop.sch, nand.sch, nor.sch, not.sch, testcounter.sch]
2013-10-23 WIP on a 4x4 dual port
    [reg4by4.sch, sramcell2.sch]
2013-10-23 Correct file name
    [reg4.sch]
2013-10-24 Starting on reg output latch
    [latch.sch, regio.sch]
2013-10-24 Fix a pin name
2013-10-24 4-by-4 is there.... but columnar would have been better.
    [reg4by4.sch, regio.sch]
2013-10-24 Organism by columns not by rows.
    [reg4.sch, reg4by4.sch]
2013-10-25 Strobes can be generated with clocks; combine WE & C# for the regs.
    [clockdrive.sch, dflipflop.sch, reg4.sch, reg4by4.sch, regio.sch]
2013-10-25 Lose a level of logic
    [nor3.sch, testcounter.sch]
2013-10-25 Break out the counter
    [counter4.sch]
2013-10-25 Test uses the separate counter.
    [testcounter.sch]
2013-10-25 Remove obsolete stuff.
    [incnp.sch, incnx.sch, incpn.sch]
2013-10-25 Full adder uses gates, save a tranny
    [andnand.sch, full.sch, nor1and.sch]
2013-10-25 Ditto fulli
    [fulli.sch]
2013-10-25 Test full* in one file, fix ups
    [full.sch, fulli.sch, testfull.sch]
2013-10-25 Move stuff into a subdir
    [andnand.sch, clockdrive.sch, counter4.sch, dflipflop.sch, flipflop.sch, full.sch, fulli.sch, jkflipflop.sch]
2013-10-25 Random tweaks
    [full.sch, fulli.sch, testclockdrive.sch]
2013-10-25 Make the reg bank fully async
    [reg4.sch, reg4by4.sch, regio.sch]
2013-10-25 Revert "Make the reg bank fully async"
    This reverts commit 3b5b615a4e4dd6360abce0d51061398da61e303b.
    [reg4.sch, reg4by4.sch, regio.sch]
2013-10-26 Put latch before registers not after
    [dlatch.sch, reg4.sch, reg4by4.sch, regio.sch]
2013-10-26 WIP on accumulate logic
    [accumulate.sch, halfi.sch]
2013-11-09 Fiddle with stuff...
    [accumulate.sch, counter4.sch, reg4.sch, regio.sch]
2013-11-09 testacc building...
    [accumulate.sch, testacc.sch]
2013-11-09 Minor fixes. Change the FF pullup from 10k to 3k3. We'd probably also get away with a 10k pullup and 22k base resistor.
    [accumulate.sch, latch.sch, reg4.sch, reg4by4.sch, regio.sch, sramcell2.sch, testacc.sch]
2013-11-10 Save 2 transistors on fulli.
    [fulli.sch, testfull.sch]
2013-11-10 Save more transistors. Make the adders output both Q and Q#.
    [accumulate.sch, dflipflop.sch, dlatch.sch, full.sch, fulli.sch, halfi.sch, reg4.sch, reg4by4.sch]
2013-11-10 Correct name of reg4by4.sym
    [accumulate.sch]
2013-11-16 Change signal names. Upgrade the test gen.
    [reg4.sch, reg4by4.sch, regio.sch, testacc.sch]
2013-11-16 Get the register polarities right.
    [reg4.sch, regio.sch, sramcell2.sch]
2013-11-19 Net names for address complements
    [accumulate.sch]
2013-11-19 Factor out the address decode; use NMOS not PMOS.
    [decode2.sch, reg4by4.sch]
2013-11-19 Replace two of the mosfets with (hopefully) lower capacitance bjts.
    [regio.sch]
2013-11-19 Pull-ups on the sense lines.
    [regio.sch]
2013-11-20 Move the input switch out of clockdrive.
    [accumulate.sch, clockdrive.sch, testacc.sch]
2013-11-20 Update testcounter. Remove obsolete file.
    [testclockdrive.sch, testcounter.sch]
2013-11-20 Add loads of LEDs... need to validate that reverse recovery time won't kill us.
    [accumulate.sch]
2013-11-21 Track adder.
2013-11-21 Renumber accumulate.
    [accumulate.sch]
2013-11-21 Renaming in register bank.
    [accumulate.sch, reg4.sch, reg4by4.sch, regio.sch]
2013-11-21 Rename in counter4.
    [counter4.sch]
2013-11-22 Clock might take a moment to stabilise.
    [testacc-check.cc]
2013-11-23 Specialise the load resistor. Add footprint.
    [accumulate.sch, andnand.sch, clockdrive.sch, flipflop.sch, full.sch, fulli.sch, latch.sch, nand.sch]
2013-11-23 Power supply / push-button circuit. Add the corresponding symbols / footprints.
    [acc-integration.sch]
2013-11-23 msop8 and push-button
2013-11-23 Right handed switch
2013-11-23 Rename the xsistor footprints
2013-11-23 Update all the transistor footprint names.
    [accumulate.sch, andnand.sch, clockdrive.sch, flipflop.sch, full.sch, fulli.sch, jkflipflop.sch, latch.sch]
2013-11-23 Resistor footprints.
    [accumulate.sch, regio.sch]
2013-11-23 Fix push-button footprint names
2013-11-23 Footprints for 0603, 0805, 1206 - geda pcb, plus my special.
2013-11-23 Convert footprints to metric
2013-11-23 Sort out soldermask clearances
2013-11-23 Normalise the pad & hole clearances. And silk width.
2013-11-23 Change from 10k to 22k base resistor
    [clockdrive.sch, reg4.sch, regio.sch, sramcell2.sch]
2013-11-23 Ready for lift-off!
    [accumulate.sch]
2013-11-24 Starting layout; grouping elements into functional blocks
    [acc-integration.pcb]
2013-11-24 Lots of relative lock down
    [acc-integration.pcb]
2013-11-26 Add a net name
    [reg4.sch]
2013-11-26 Start routing up the registers
    [acc-integration.pcb, accumulate.sch]
2013-11-26 Looks like rotating the resistors will work out
    [acc-integration.pcb]
2013-11-26 Route up the register internals
    [acc-integration.pcb]
2013-11-26 Routed A decode
    [acc-integration.pcb, decode2.sch]
2013-11-27 Routed B decode
    [acc-integration.pcb]
2013-11-27 Flip the two input transistors on the jk-flip-flop - will make routing a little easier.
    [jkflipflop.sch]
2013-11-29 First counter stage routed
    [acc-integration.pcb]
2013-11-29 Route the other counter flip-flops
    [acc-integration.pcb]
2013-11-29 Wire up the counter power and clock
    [acc-integration.pcb]
2013-11-29 Integrate sense pull-ups into register array
    [acc-integration.pcb]
2013-11-29 Rename some components to make geda pcb happy.... Everything got a bit borked so went round in circles.
    [acc-integration.pcb, acc-integration.sch, accumulate.sch]
2013-11-30 First reg I/O routed
    [acc-integration.pcb]
2013-11-30 Second reg I/O routed
    [acc-integration.pcb]
2013-11-30 Route the remaining reg I/O logic
    [acc-integration.pcb]
2013-11-30 Switch around nets inside the adders a bit - makes routing easier.
    [full.sch, fulli.sch]
2013-11-30 First adder stage routed
    [acc-integration.pcb]
2013-11-30 Third adder stage routed
    [acc-integration.pcb]
2013-11-30 Also switch around halfi...
    [halfi.sch]
2013-12-01 Start connecting blocks together
    [acc-integration.pcb]
2013-12-01 Switch resistors/LEDs to make routing easier
    [accumulate.sch]
2013-12-01 Bringing in leds.
    [acc-integration.pcb]
2013-12-02 Registers & adder tied together; ready to move...
    [acc-integration.pcb]
2013-12-02 First move up accomplished...
    [acc-integration.pcb]
2013-12-02 Second move-up
    [acc-integration.pcb]
2013-12-03 Trim a couple of lines.
    [acc-integration.pcb]
2013-12-03 Wiring up for counter connections
    [acc-integration.pcb]
2013-12-03 Move up counter
    [acc-integration.pcb]
2013-12-04 Hook up counter LEDs
    [acc-integration.pcb, accumulate.sch]
2013-12-04 Fitting onto 50x100
    [acc-integration.pcb]
2013-12-04 Change switches from pairs of SPST to single SPDT
    [acc-integration.pcb, acc-integration.sch, accumulate.sch]
2013-12-05 Make names consistent; flip two nets
    [acc-integration.sch, accumulate.sch]
2013-12-05 All on board
    [acc-integration.pcb]
2013-12-06 Counter carry gens routed
    [acc-integration.pcb]
2013-12-06 Hide a load of element names
    [acc-integration.pcb]
2013-12-07 Power converter routed. Use a push button not a side switch.
    [acc-integration.pcb, acc-integration.sch, accumulate.sch]
2013-12-07 All routed
    [acc-integration.pcb, accumulate.sch]
2013-12-07 Ground pour, top and bottom
    [acc-integration.pcb]
2013-12-07 More connectivity
    [acc-integration.pcb]
2013-12-07 Decoupling caps are in
    [acc-integration.pcb, acc-integration.sch]
2013-12-07 Clean up ground traces again
    [acc-integration.pcb]
2013-12-08 Outline layer
    [acc-integration.pcb]
2013-12-08 Metricate the 0805 and 1206
    [acc-integration.pcb]
2013-12-08 Metricate the 0603 footprints.
    [acc-integration.pcb]
2013-12-08 Reduce scale of all invisible text
    [acc-integration.pcb]
2013-12-08 Translate everything to top left, resize board
    [acc-integration.pcb]
2013-12-08 Restore needed clearlines.
    [acc-integration.pcb]
2013-12-08 Rename the board
    [accumulate.pcb]
2013-12-08 Hopefully, off to fab
    [BoardOutline.gbr, BotSide.gbr, BotSilkscreen.gbr, BotSoldermask.gbr, TopSide.gbr, TopSilkscreen.gbr, TopSolderMask.gbr]
2013-12-15 Short-circuit leading zeros on power. Seven bytes instruction; big save on small exponents.
    [rmsim.cc]
2013-12-16 Bug fixes ... Classify was wrong. If we get through the squaring, that's composite. Fix the main-loop iteration. Costs 4 bytes (234).
    [rmsim.cc]
2013-12-16 Classify does zero test - saves 3 bytes (231). Fix accounting for OR
    [rmsim.cc]
2013-12-16 Bug fix - use the correct base...
    [rmsim.cc]
2013-12-16 Bug fix - correct squaring loop iteration.
    [rmsim.cc]
2013-12-16 Current state of play wrt design.
2013-12-26 alu runs basic test
    [alu.sch, nandor.sch, nandor3.sch]
2013-12-29 testalu passes
    [alu.sch, testalu.sch]
2013-12-29 Add dual alu also
    [alui.sch, testalu.sch]
2013-12-30 Don't invert carries... Can optimise with BJTs later. We gain by absorbing inverters any way...
    [alu.sch, alui.sch, nor1and.sch, testalu.sch]
2013-12-30 Absorb negations into the ALU logic. Only need single ended inputs now.
    [alu.sch, nand1or3.sch, nand3.sch, nor.sch, not.sch, testalu.sch]
2013-12-30 Remove unused pin
2013-12-30 Split power supply for the alu output.
    [alu.sch, testalu.sch]
2013-12-30 Outputs on the register ram cell.
    [reg4.sch, sramcell2.sch]
2013-12-30 Send slowest signals to (hopefully) fastest inputs
    [alu.sch]
2013-12-30 Move tests into test subdir.
    [testacc.sch, testcounter.sch, testfull.sch]
2013-12-31 Trivial changes - update gschem version, tweak drawing.
    [accumulate.sch, flipflop.sch, latch.sch, nand.sch, not.sch, reg4by4.sch, regio.sch, rslatch.sch]
2013-12-31 Fix position of new pin
2014-01-01 Simplify refdefs on lots of things.
    [andnand.sch, clockdrive.sch, counter4.sch, decode2.sch, full.sch, fulli.sch, halfi.sch, jkflipflop.sch]
2014-01-01 Disambiguations to allow not having separators.
    [counter4.sch, jkflipflop.sch, reg4.sch, reg4by4.sch]
2014-01-01 Rework jkflipflop
    [jkflipflop.sch]
2014-01-01 More refdes simplification
    [clockdrive.sch, full.sch, fulli.sch, halfi.sch, nand1or3.sch]
2014-01-01 SP with pre-dec and post-inc operations. Can optimize the FF strobing a bit...
    [dflipflop.sch, flipflop.sch, sp.sch, testsp.sch]
2014-01-01 D flip flop was inverted...
    [dflipflop.sch, sp.sch]
2014-01-02 Add separate carry power to the x(n)or
    [alu.sch, inc8.sch, sp.sch, xnor.sch, xor.sch]
2014-01-02 Rename power
    [sramcell2.sch]
2014-01-05 Major rework... Single phase clocking. Proper non-overlap drives.
    [alu.sch, flipflopbias.sch, noverlap.sch, pcbit.sch, rslatch.sch, slice.sch, sp.sch, testacc.sch]
2014-01-05 Remove unused and suboptimal
    [dflipflop.sch, flipflop.sch, latch.sch, nandor3.sch]
2014-01-05 Tweak test parameters.
    [testvdflipflop.sch]
2014-01-05 Don't use open drains driving vdflipflops - glitches looked scary.
    [alu.sch, sp.sch, testvdflipflop.sch, xorod.sch]
2014-01-05 Use Vdd consistently
    [alu.sch, counter4.sch, decode2.sch, full.sch, fulli.sch, halfi.sch, reg4.sch, reg4by4.sch]
2014-01-06 CMOS not gate
    [clockdrive.sch, cnot.sch, pcbit.sch, testvdflipflop.sch]
2014-01-06 Test inc8; 730kHz through flipflops
    [inc8.sch, testinc8.sch]
2014-01-06 Uh, let's have a proper ref.
    [cnot.sch]
2014-01-07 Start on decode
    [decode.sch, dlatch.sch, dlatch6.sch, pcdecode.sch]
2014-01-08 Test for impact of clock skew on flip-flop
    [skew.sch]
2014-01-08 Use desired widths and specialise latch types
    [decode.sch, dlatch8.sch, rslatch6.sch]
2014-01-09 vdlatch, and a nor gate with a bipolar input. Use thes as appropriate.
    [decode.sch, norb.sch, vdlatch.sch]
2014-01-15 Test divide-by-2 speed.
    [divide.sch]
2014-01-15 Remove obsolete file
    [dlatch6.sch]
2014-01-19 Sram board
    [sram16byte.sch, sram32byte.sch, sram4byte.sch, srambyte.sch, sramio.sch]
2014-01-23 Rework noverlap to have stronger output drive. Note that the PMOS were currently using is much weaker than the NMOS.
    [noverlap.sch, testnoverlap.sch]
2014-01-24 Smaller GND and Vdd symbols
2014-01-24 Fix vdlatch
    [vdlatch.sch]
2014-01-24 Permute sram addressing
    [sram32byte.sch]
2014-01-24 Fix clock connection
    [dlatch8.sch]
2014-01-24 Number; make uncond. simpler
    [pcdecode.sch]
2014-01-25 Decoder for register strobes
    [decoder.sch]
2014-01-25 Test pcdecode
    [nor4.sch, pcdecode.sch, testpcdecode.sch]
2014-01-25 Clean-up xnor.
    [inc8.sch, xnor.sch]
2014-01-25 Rearrange slice
    [slice.sch]
2014-01-25 WIP on decode.
    [decode.sch]
2014-01-25 Rename decode.sch to opbuf; fix it up
    [decode.sch, opbuf.sch]
2014-01-26 Tweak labels
    [pcbit.sch]
2014-01-26 Simplify sp.sch
    [sp.sch]
2014-01-26 Add a footprint to all in/out symbols - useful for board planning.
    [alu.sch, andnand.sch, clockdrive.sch, cnot.sch, counter4.sch, decode2.sch, decoder.sch, dlatch.sch]
2014-01-26 Make AR# dominate AS
    [slice.sch]
2014-01-26 WIP on main decode
    [opdecode.sch]
2014-01-26 Flag registers
    [flags.sch]
2014-01-26 Rearrange. Assert AR, CR on special. Remove duplicate CS.
    [opdecode.sch]
2014-01-26 Assert CinR on specials
    [opdecode.sch]
2014-01-27 Get opdecode passing a test; rearrange dominances to match
    [alu.sch, opdecode.sch, slice.sch]
2014-01-27 Swapping CMP and XOR simplifies the decode. Actually add the test.
    [opdecode.sch, testopdecode.sch]
2014-01-27 Invert two of the instruction bits.
    [opdecode.sch]
2014-01-27 Add E4 and E5 decodes
    [opdecode.sch, testopdecode.sch]
2014-01-27 That should be e3/e4 not e4/e5.
    [opdecode.sch]
2014-01-28 Make ALU A,B positive. Make opdecode match & fix carries. Some cmos drivers...
    [alu.sch, opdecode.sch, testalu.sch, testopdecode.sch]
2014-01-28 Simplify. Tidy.
    [nand4.sch, opdecode.sch]
2014-01-28 Use push-pull drivers for CR,CS,AR,AS. Move the (B xor N) out of the ALU into the slice.
    [alu.sch, slice.sch, testalu.sch]
2014-01-29 Get going again... CinR/CinS flags are grevious...
    [opdecode.sch, slice.sch, testopdecode.sch]
2014-01-29 Disentangle CinS... That silly inverter was unnecessary.
    [opdecode.sch]
2014-01-29 Remove the bus, use netnames instead...
    [opdecode.sch]
2014-01-30 Move stuff about
    [opdecode.sch]
2014-01-30 Take E3,E4 into the opcode buffers
    [opbuf.sch, rslatch4v2.sch]
2014-01-31 Internal node reduction on jump flag
    [pcdecode.sch]
2014-01-31 Move ret to 101xxxxx
    [pcdecode.sch]
2014-01-31 Simplify layout
    [pcdecode.sch]
2014-01-31 A decode I'm happy with ... but we can simplify.
    [pcdecode.sch]
2014-01-31 Simplify by just cancelling rets we don't want
    [pcdecode.sch]
2014-01-31 Simplify by removing inverters.
    [pcdecode.sch]
2014-01-31 Use gate not trannies
    [pcdecode.sch]
2014-01-31 Sharing is caring.
    [pcdecode.sch]
2014-02-01 Rest of the op decode is in...
    [nandod.sch, norod.sch, opbuf.sch, opdecode.sch, testopdecode.sch]
2014-02-01 vdlatch is identical to dlatch so remove it.
    [dlatch.sch, opbuf.sch, rslatch4v2.sch, vdlatch.sch]
2014-02-01 Add Z output to slive. Name everything.
    [slice.sch]
2014-02-01 Random tidy
    [vdilatch.sch]
2014-02-02 128 byte rom
    [romio.sch, romquad.sch, romquad8.sch]
2014-02-02 Flags has the Z pullup and C forcing. Tweaks etc.
    [flags.sch, opdecode.sch, slice.sch]
2014-02-02 Fixes and cleanups
    [sram16byte.sch, sram32byte.sch, sram4byte.sch]
2014-02-02 Reset latches
    [reset.sch]
2014-02-03 Replace tranies with od
    [pcdecode.sch]
2014-02-03 Relabel ... won't just be for main regs
    [decoder.sch]
2014-02-04 Dual phase divide; about 1/3 µs propagation.
    [divide.sch, trflipflop.sch]
2014-02-04 Goes a bit faster with picked duty cycle
    [divide.sch]
2014-02-05 Four stage divider is a bit slower
    [divide.sch]
2014-02-05 Rename romlink to linko / linkc
    [romquad.sch]
2014-02-05 Attempt at divide-by-nine with first ff single phase. Looks like the reset skew misses the first ff...
    [divide.sch, trflipflop.sch]
2014-02-05 At slow clocks, works fine
    [divide.sch]
2014-02-06 Dualise; ff version of /9 working nicely.
    [divide.sch, trflipflop.sch]
2014-02-06 Reset both FF stages. Tidy.
    [divide.sch]
2014-02-08 Divide by 3...
    [divide.sch]
2014-02-08 Ok at 2MHz with a load.
    [divide.sch]
2014-02-10 Make STA# open-drain
    [opdecode.sch]
2014-02-10 Add symbol for slice
    [slice.sch]
2014-02-10 Bulk of cpu is there... need to drive various signals still.
    [cpu.sch, flags.sch, opbuf.sch, opdecode.sch]
2014-02-10 Trivial fixes.
    [cpu.sch, reg4by4.sch, slice.sch]
2014-02-10 Rename file
    [rom128byte.sch]
2014-02-12 PC board
    [pc.sch, pcbit.sch, sp.sch, testsp.sch]
2014-02-13 Adjust assembler for how we actually process constants.
2014-02-14 Accumulate's job is done; it's on a branch. remove half/full(i).
    [acc-integration.sch, accumulate.pcb, accumulate.sch, full.sch, fulli.sch, halfi.sch, testacc.sch, testfull.sch]
2014-02-14 Remove stuff only used by accumulate
    [counter4.sch, jkflipflop.sch, reg4.sch, reg4by4.sch, regio.sch, testcounter.sch]
2014-02-15 Clock divider and driver. Oscillator not-yet-in.
    [clockgen.sch, clocking.sch]
2014-02-16 CMOS oscillator works better, now the thresholds are saner. Test circuit.
    [osc.sch, testosc.sch]
2014-02-16 Put an inverting buffer after the first divider stage
    [clockgen.sch]
2014-02-17 Use diodes to limit the oscillator power
    [osc.sch]
2014-02-17 Minor fixes to sp.
    [sp.sch]
2014-02-18 Don't complicate to not put slow top
    [sp.sch]
2014-02-18 Symbol for clocks. And tidy
    [clocking.sch]
2014-02-18 Add clocking to pc board
    [pc.sch]
2014-02-19 Tweak lots of labels in symbols, propagate into schems.
    [cpu.sch, opbuf.sch, pc.sch, rom128byte.sch, slice.sch, sram32byte.sch]
2014-02-19 Had forgotten V/V# nets on the slices.
    [cpu.sch]
2014-03-01 AC decouple the oscillator output
    [osc.sch]
2014-03-08 Move the clock dividers into osc
    [clockgen.sch, osc.sch, testosc.sch]
2014-03-08 Correct name of STA#.
    [pc.sch]
2014-03-08 Separate power input for the 2-4 decoder outputs.
    [cpu.sch, decoder.sch, pc.sch]
2014-03-08 Sensible pin naming on x(n)or.
    [xnor.sch, xor.sch]
2014-03-08 Trivial clean.
    [inc8.sch]
2014-03-08 Add missing I/O pins
    [cpu.sch, pc.sch]
2014-03-08 Minor corrections
    [slice.sch, sram32byte.sch]
2014-03-11 Generate mem-read strobe from CPU.
    [cpu.sch, opdecode.sch]
2014-03-11 Fix jump target high bits.
    [pc.sch]
2014-03-11 Get K v. K# right.
    [cpu.sch, opbuf.sch]
2014-03-11 Get register polarity correct in slice.
    [slice.sch]
2014-04-24 WIP on integrating the sram
    [notb.sch, sram32byte.sch, sramio.sch]
2014-07-08 Fix pin names on sram32 symbol.
2014-07-08 Fixup sram32 address lines. Simplify.
    [sram32byte.sch]
2014-07-18 Getting stuff together, fixups all over the places.
    [cpu.sch, opbuf.sch, pc.sch, pcdecode.sch, reset.sch, vdflipflop.sch]
2014-07-18 Top level for simulation
    [universe.sch]
2014-08-09 Use PNP not NMOS for strobe
    [srambyte.sch]
2014-08-09 Used named-nets not lines for the sram stuff.
    [sram16byte.sch, sram32byte.sch, sram4byte.sch]
2014-08-09 PCI connectors
    [pci-conn-3v.pcb, pci-edge-3v.pcb]
2014-08-10 Fix-up polarity of the RAM strobes. Buffers on the A bus drives. Various tweaks.
    [cpu.sch, slice.sch, sram32byte.sch, sramio.sch, universe.sch]
2014-08-10 Fast fake simulation using switches
2014-08-10 Fix a refdes.
    [testalu.sch]
2014-08-10 Get testsp going again. Add test checker. Works with fakery.
    [testsp.sch]
2014-08-10 Account for the inverter in the path throuh PCBIT.
    [pcbit.sch]
2014-08-10 Disambiquate refdes in norb.
    [norb.sch]
2014-08-10 MR is generated in opdecode ... no need to duplicate.
    [cpu.sch]
2014-08-10 Remove duplicate power rails.
    [pc.sch]
2014-08-17 Fix pin-labels.
2014-08-17 Add pull-ups on opcode lines
    [pc.sch]
2014-08-17 Minor tweaks.
    [universe.sch]
2014-08-17 Add missing ground.
    [romio.sch]
2014-08-17 Try deleting netnames that might be hiding pins.
    [sramcell2.sch]
2014-08-17 Pins not netnames in opdecode.
    [opdecode.sch]
2014-08-17 Fix power connections on rom.
    [rom128byte.sch, universe.sch]
2014-10-08 The R line on sramcell2 ended up with a naming collision. Fixit.
    [sramcell2.sch]
2014-10-08 Add reset to universe. Clean-up loose ends
    [universe.sch]
2014-10-08 Internal IN# net was not connected.... do it.
    [opdecode.sch]
2014-10-24 FPGA power
2014-10-24 Fill in pin numbers on config & gnd
2014-10-24 Add the missing vbatt pin.
2014-10-24 Fix a typo.
    [universe.sch]
2014-11-11 Various bits & pieces for the IO board
2014-11-11 Use J0# not J0.
    [pc.sch]
2014-11-11 Add BV to the opdecode
    [cpu.sch, opdecode.sch]
2014-11-11 Fixup the quad diode
2014-11-19 Put pullup resistors on the rom strobes. Hmmmm... should switch to just gates. Also fix the polarity of the rom address lines.
    [rom128byte.sch, romquad8.sch]
2014-11-19 The bss84 model I was using appeared to have unrealistically high on resistance. Replace with another model (Zetex '00) that appears more realistic. The transistors I am actually using have superior 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
2014-11-19 A-to-alu had wrong polarity; fix it.
    [slice.sch]
2014-11-19 Name some nets
    [slice.sch]
2014-11-19 Fix the priorities of the carry strobes.
    [flags.sch]
2014-11-19 cs# needs a complemantory driver.
    [opdecode.sch]
2014-11-19 Shuffle things around in prep for adding vk#.
    [cpu.sch]
2014-11-19 Strobe the register to V connection.
    [cpu.sch, opbuf.sch, slice.sch]
2014-11-19 Add some more signal names.
    [slice.sch]
2014-11-19 Adjust some labels.
    [alu.sch, xnor.sch]
2014-11-19 The flags were a bit messed up...
    [cpu.sch, flags.sch]
2014-11-19 dlatch doesn't need a BJT.
    [dlatch.sch]
2014-11-19 First cut of binary-level simulation.
2014-11-19 Correct signal name to WU from WZ.
    [cpu.sch]
2014-11-19 Add source v. assembled checking.
2014-11-20 Add runtime checks to assembly.
2014-11-20 Fix parity of popped return address.
    [pcbit.sch]
2014-11-20 Ressurrect opdecode unittest.
    [testopdecode.sch]
2014-11-20 Make AR/AS exact.
    [opdecode.sch]
2014-11-20 Uh, having univlight in version control might help...
    [univlight.sch]
2014-11-20 Switch inc/dec. Simplify carry-in logic.
    [cpu.sch, flags.sch, opdecode.sch, testopdecode.sch]
2014-11-21 Name some nets in the memory logic.
    [sram16byte.sch, sram4byte.sch, srambyte.sch]
2014-11-22 Put pullups on the sram bit lines.
    [sramio.sch]
2014-11-22 Test for memory hazards due to address lines switching too quickly.
2014-11-22 Slow down the noverlap.
    [noverlap.sch]
2014-11-22 Avoid glitches on MW due to switching parasitics.
    [opdecode.sch]
2014-11-23 Add dilatch; vdilatch is just too dodgy.
    [dilatch.sch, testdilatch.sch]
2014-11-23 Remove the PC Q outputs; just use the buffered P output.
    [pc.sch, pcbit.sch]
2014-11-24 Use dilatch not vdilatch.
    [flags.sch, slice.sch]
2014-11-24 Change vdflipflop to dflipflop.
    [dflipflop.sch]
2014-11-29 Fix up a remaining vdflipflop.
    [reset.sch]
2014-11-29 Pull-down resistors on the rom sense transistor bases. Use PMOS not PNP for the sense lines.
    [romio.sch, romquad.sch]
2014-11-30 Frig around with text labels.
    [rslatch.sch, sramcell.sch]
2015-11-04 Switch to k26
2015-12-11 Start on slice layout
    [slice.pcb, slice.sch]
2015-12-11 Footprint needed for slice layout
2015-12-12 One pair of registers laid out; 3 extra lines in each direction.
    [slice.pcb]
2015-12-12 The 4 registers laid out.
    [slice.pcb]
2015-12-12 Permute some lines in the ALU.
    [alu.sch]
2015-12-12 Permute nand1or - more grounds, fewer internals.
    [nand1or.sch]
2015-12-15 Put in the register latch.
    [slice.pcb]
2015-12-15 Straighten stuff.
    [slice.pcb]
2015-12-16 ALU internal wiring.
    [slice.pcb]
2015-12-16 Join up the ALU and register file.
    [slice.pcb]
2015-12-16 Insert M4 (reg to V switch).
    [slice.pcb]
2015-12-20 Remove the per slice V/R switch; instead rely on gating read strobes.
    [cpu.sch, opbuf.sch, slice.pcb, slice.sch]
2016-02-08 Address driver in.
    [slice.pcb]
2016-02-11 Permute the address driver a bit. Simplify.
    [slice.pcb]
2016-02-11 Start on flipflop layout
    [flipflops.pcb, flipflops.sch]
2018-02-13 Add a basic verilog model.
    We don't have the short-circuit forward of cond flags into cond rets.
    [discus.v]
2018-02-13 Update the assembler to emit a prefix RET CC instructions.
2018-02-18 Force use of a carry chain for decode effZ.
    Fix the nextPC...
    [discus.v]
2018-02-20 Some bugfixes. Move isolated parts of decode into fetch.
    [discus.v]
2018-03-03 verilog model: Rework condition handling. Add a reset input.
    [discus.v]
2018-03-04 Rework the SP handling.
    [discus.v]
2021-02-05 Add a missing file.
    [monitor.cc]
2021-02-05 Add strong-drive latches instead of buffering.
    [alu.sch, cnot.sch, decoder.sch, dflipflops.sch, nor1and.sch, opdecode.sch, pc.sch, pcbit.sch]
2021-02-05 Reduce "infinite" to 1e8, makes spice happier.
    [romquad.sch]
2021-02-06 Start on purification.
    [bit.sch, tappedxnor.sch]
2021-02-07 Getting there with the new decode...
    [alu.sch, bit.sch, decode.sch, xor.sch]
2021-02-07 Interminable gschem updates.
    [cpu.sch, dflipflop.sch, dlatch.sch, nand.sch, nand1or.sch, nand1or3.sch, nand3.sch, opbuf.sch]
2021-02-07 Factor out the 4 way decode.
    [decode.sch, decoder.sch, pc.sch]
2021-02-07 Tidy up a bit. Fix carry-force.
    [decode.sch, decoder.sch, dilatch.sch, sramio.sch]
2021-02-07 Split decode into control+decode.
    [control.sch, decode.sch]
2021-02-08 Symbols for everything, a big tidy-up & fixes.
    [bit.sch, control.sch, decode.sch, notp.sch, sp.sch, tappedxnor.sch, xor2g.sch]
2021-02-08 Getting testopdecode going...
    [alu.sch, bit.sch, control.sch, decode.sch, testopdecode.sch]
2021-02-08 opdecode passes the current tests.
    [decode.sch, nor.sch, notp.sch, testopdecode.sch]
2021-02-08 Get the rest of the flags flying.
    [decode.sch, testopdecode.sch]
2021-02-08 Internal node optimisations.
    [control.sch, decode.sch, nor1and3.sch, testopdecode.sch]
2021-02-08 Get testpcdecode going again.
    [control.sch, decode.sch, testpcdecode.sch]
2021-02-09 Dualize the OR strobe.
    [alu.sch, bit.sch, decode.sch, testalu.sch, testopdecode.sch, xor.sch]
2021-02-09 Get testsp going again. Run tests from makefile.
    [bit.sch, control.sch, decode.sch, sp.sch, testalu.sch, testopdecode.sch, testpcdecode.sch, testsp.sch]
2021-02-09 Update assembler for new coding.
    [testsp.sch]
2021-02-09 Working on getting univlite back.
    [norb.sch, univlight.sch]
2021-02-10 Feature complete again.
    [clockdrive.sch, clocking.sch, control.sch, decode.sch, rom128byte.sch, romio.sch, sram32byte.sch, sramio.sch]
2021-02-10 Save a transistor on the alu.
    [alu.sch]
2021-02-10 Lots of fix-ups.
    [bit.sch, control.sch, romquad.sch, romquad8.sch, sram4byte.sch, srambyte.sch, univlight.sch]
2021-02-11 Fixes to the interpretation of the new opcodes.
    [control.sch, noverlap.sch, univlight.sch]
2021-02-12 testadd flies again.
    [bit.sch, control.sch, decode.sch, norod.sch, romio.sch, safe1of5.sch, sram32byte.sch, sramcell.sch]
2021-02-12 testcall is back.
    [bit.sch]
2021-02-12 testinc is back up.
    [bit.sch]
2021-02-13 testmem flies.
    [noverlap.sch, sram16byte.sch, sramio.sch]
2021-02-13 hazard flies.
    [control.sch, decode.sch, nor3od.sch, noverlap.sch, safe1of4.sch, sram16byte.sch, sram32byte.sch, sram4byte.sch]
2021-02-13 Sort out the ojump mess.
    [control.sch]
2021-02-13 Tidy ups.
    [control.sch, decode.sch, sramio.sch]
2021-02-13 Simplify reset.
    [control.sch]
2021-02-14 Simplify reset more.
    [control.sch, decode.sch, univlight.sch]
2021-02-14 Remove noverlap from address lines.
    [bit.sch, sramio.sch, testdflipflop.sch]
2021-02-14 Gray coded sp
    [control.sch, decode.sch, seli.sch, sp.sch, testpcdecode.sch, testsp.sch]
2021-02-14 Replace xor with a sel for the ALU input inverter.
    [bit.sch]
2021-02-14 Implement precharge/late read for the stack.
    [bit.sch, decode.sch, nandor.sch, sp.sch, testpcdecode.sch, testsp.sch]
2021-02-15 Simplify control; Z handling and reg write decode.
    [control.sch, decode.sch, glitch1of5.sch, testopdecode.sch]
2021-02-15 Logic gate stacking in control & decode.
    [bit.sch, control.sch, decode.sch]
2021-02-15 Strobe & stack OUT.
    [control.sch, decode.sch, testopdecode.sch, univlight.sch]
2021-02-15 Another one bites the dust.
    [control.sch, decode.sch]
2021-02-15 Nix one from reset.
    [control.sch, decode.sch]
2021-02-15 Two more tests; fix cmp.
    [decode.sch, noverlap.sch, sram32byte.sch, univlight.sch]
2021-02-17 Use named nets more in bit. Tweak font sizes.
    [bit.sch, control.sch, decode.sch, nandod.sch, not.sch, sramio.sch]
2021-02-17 No need to special case reset in instruction decode.
    [control.sch]
2021-02-17 Just write K on every cycle; no need to be precise.
    [bit.sch, control.sch, glitch1of5.sch, sp.sch, univlight.sch]
2021-02-18 Integrated clock drive.
    [control.sch, univlight.sch]
2021-02-18 Tweak the way pc & stack are handled.
    [bit.sch]
2021-02-18 Use resistors not logic to mitigate the register read strobe hazard.
    [control.sch, decode.sch, sramcell2.sch, sramcell2s.sch]
2021-02-19 README updates.
    [alu.sch, bit.sch]
2021-02-19 Simplify the SP decode further.
    [sp.sch]
2021-02-19 Routine tidy up.
    [bit.sch, dilatch.sch, sramcell2.sch]
2021-02-19 First cut of webbased hyperlinking.
    [bit.sch]
2021-02-21 Major tidy up.
    [alu.sch, bit.sch, cnot.sch, control.sch, decode.sch, dflipflop.sch, dflipflops.sch, dilatch.sch]
2021-02-23 Switch to dram.
    [bit.sch, control.sch, decode.sch, dram16byte.sch, dram4byte.sch, dram64byte.sch, drambyte.sch, dramio.sch]
2021-02-23 Move docs into their own directory.
    [bit.sch, decode2.sch, glitch1of5.sch, osc.sch, safe1of5.sch, universe.sch]
2021-02-25 Switch DRAM to 8 by 8 decode.
    [dram16byte.sch, dram4byte.sch, dram64byte.sch, drambyte.sch, dramio.sch, eightn.sch, eightp.sch]
2021-02-26 Add Schottky diodes to the DRAM byte.
    [bit.sch, dram16byte.sch, dram4byte.sch, dram64byte.sch, drambyte.sch, dramio.sch, eightn.sch]
2021-02-27 Simplify ROM, 64 byte board.
    [bit.sch, control.sch, halfadd.sch, rom128byte.sch, rom16byte.sch, rom4byte.sch, rom64byte.sch, rombyte.sch]
2021-02-27 Reset becomes flip-flop
    [control.sch, decoder.sch]
2021-02-27 Get jiggy with pull-down diodes.
    [bit.sch, control.sch, fourpd.sch, noverlap.sch, rom4byte.sch, rombyte.sch, sp.sch]
2021-02-27 Use 4T not 6T for the second flip-flop stage.
    [bit.sch, dflipflop.sch, dflipflops.sch, nand1or.sch, rslatch.sch, rslatchs.sch, skew.sch, sramcell2.sch]
2021-02-27 Big clock rename.
    [bit.sch, control.sch, decode.sch, dram64byte.sch, dramio.sch, sp.sch, testsp.sch, universe.sch]
2021-02-27 Switch flip-flops completely to new latches.
    [bit.sch, control.sch, dflipflop.sch, dflipflops.sch, dlatch.sch, sp.sch, sramcellw.sch]
2021-02-27 Kill dilatch entirely.
    [bit.sch, control.sch, dilatch.sch, dlatch.sch, sramcells.sch, sramcellw.sch]
2021-02-28 Name all nets connecting to 3 or more transistors.
    [alu.sch, bit.sch, control.sch, decode.sch, decoder.sch, eightn.sch, eightp.sch, fourpd.sch]
2021-02-28 Set origins. Renumber.
    [alu.sch, bit.sch, cnot.sch, dflipflop.sch, dflipflops.sch, dram4byte.sch, dram64byte.sch, drambyte.sch]
2021-03-02 Move to 360p on the dram.
    [drambyte.sch]
2021-03-02 Make the names of the basic switching elements generic.
    [alu.sch, andnand.sch, bit.sch, cnot.sch, control.sch, decode.sch, decoder.sch, drambyte.sch]
2021-03-03 Flip NMOS over to FDV301N.
    [control.sch, testsp.sch]
2021-03-03 Make the flip-flop stages robust against glitches.
    [dlatch.sch, sramcells.sch, sramcellw.sch]
2021-03-03 New dilatch, use it in FFs.
    [dflipflop.sch]
2021-03-03 Update ffs to use the new latches.
    [dflipflops.sch, dilatch.sch, sramcells.sch]
2021-03-03 Make DRAM precharge closer to threshold voltage. Gets DRAM working at lower Vto.
    [bit.sch, dram64byte.sch, drambyte.sch, dramio.sch]
2021-03-03 Remove the remaining dlatches.
    [bit.sch, control.sch, dram64byte.sch]
2021-03-03 Remove unnecessary clock dist.
    [bit.sch, control.sch, dflipflop.sch, dflipflops.sch, sp.sch, univlight.sch]
2021-03-03 Use dplatch where possible.
    [bit.sch, control.sch, diplatch.sch, dpflipflop.sch, dpflipflops.sch, sp.sch, univlight.sch]
2021-03-04 Another round of tidy ups. Rebuild docs.
    [bit.sch, dram64byte.sch]
2021-03-04 Move to 200kHz for the main sim.
    [univlight.sch]
2021-03-04 Docs and net naming.
    [bit.sch, decode.sch, dilatch.sch, diplatch.sch, dramio.sch, norod.sch]
2021-03-05 Change the PMOS switch
2021-03-05 Pmos on the clock input chain.
    [noverlap.sch, univlight.sch]
2021-03-05 Rename to W from D on the ram inputs
    [dram64byte.sch, dramio.sch]
2021-03-05 Read strobes were drifting down too slowly, use a different arrangement.
    [control.sch, decode.sch, fiveof8.sch]
2021-03-05 Redo the ROM decode, the 8×8 only saved 1 transistor and was slow.
    [fourp.sch, fourpd.sch, rom16byte.sch, rom4byte.sch, rom64byte.sch]
2021-03-05 Redo the ram decode. Add tests for ram and rom decode.
    [dram16byte.sch, dram4byte.sch, dram64byte.sch, rombyte.sch, testramdecode.sch, testromdecode.sch]
2021-03-05 Rebalance the ram fanout.
    [dram64byte.sch, drambyte.sch]
2021-03-06 Simulate at 250kHz, NX3008 for the PMOS.
    [decode.sch, noverlap.sch, romio.sch, univlight.sch]
2021-03-06 Web update, remove unused items.
    [eightn.sch, eightp.sch]
2021-03-06 300kHz operation.
    [univlight.sch]
2021-03-06 Get running with higher reverse capacitance on the NPN.
    [bit.sch, dram64byte.sch, dramio.sch, sramcell2.sch, sramcell2s.sch]
2021-03-07 Use 2sc4774 & separate resistor in the dram banks.
    [dram4byte.sch, dram64byte.sch, drambyte.sch]
2021-03-08 Change 3k3 to rload everywhere, so I only have only place to change.
    [andnand.sch, control.sch, decode.sch, decoder.sch, drambyte.sch, fourpd.sch, nand.sch, nand1or.sch]
2021-03-08 Use a better transistor on the register readout.
    [bit.sch, noth.sch, sramcell2.sch, sramcell2s.sch]
2021-03-08 Flying at 3µs timing.
    [fiveof8.sch, sramcell2s.sch, univlight.sch]
2021-03-09 Symbol for the strong pull resistor.
    [decode.sch, univlight.sch]
2021-03-10 Rearrange decode slightly
    [control.sch, decode.sch, dram64byte.sch, nand3od.sch, nor4od.sch, sramcell2.sch, sramcells.sch, sramcellsw.sch]
2021-03-12 Use a pot for the bias voltage.
    [bit.sch, decode.sch, dram64byte.sch, drambyte.sch, noth.sch]
2021-03-12 Fixup spice-load & verification.
    [spice_load.cc]
2021-03-13 2.7V operation
    [diplatch.sch, univlight.sch]
2021-03-14 2.5v operation.
    [univlight.sch]
2021-03-14 Fix up handling of the verification cycle time & make it configurable.
    [spice_load.cc, substrate.py]
2021-03-15 Operation at 400kHz
    [bit.sch, fiveof8.sch, selis.sch, sramcell2.sch, sramcell2s.sch, univlight.sch]
2021-03-16 Add bling
    [bit.sch, control.sch, univlight.sch]
2021-03-19 Minor updates and fixes. Remove unused files.
    [decoder.sch, dflipflops.sch, fourpd.sch]
2021-03-20 Rename a couple of nets.
    [bit.sch, control.sch, univlight.sch]
2021-03-20 New opcodes for misc insns.
    [alu.sch, control.sch, decode.sch, nots.sch, testopdecode.sch]
2021-03-20 Get rid of Z flipflop - generate Z off K instead.
    [bit.sch, control.sch, decode.sch, sramcell2t.sch, testopdecode.sch, testpcdecode.sch]
2021-03-20 Rationalise some decode strobes.
    [control.sch, decode.sch, testopdecode.sch]
2021-03-20 More rearrange.
    [control.sch]
2021-03-20 Convert C into a DE ff.
    [control.sch, decode.sch, deflipflop.sch, dielatch.sch, testopdecode.sch]
2021-03-21 Simplify reg read/write stobe latching.
    Simplify CW#.
    [control.sch, decode.sch, nand4od.sch]
2021-03-21 Tidy up
    [bit.sch, control.sch, decode.sch, univlight.sch]
2021-03-21 Name some nets.
    [control.sch, decode.sch, dram16byte.sch, dram64byte.sch, fiveof8.sch, selis.sch]
2021-03-23 Strong I + BK flip flops.
    [bit.sch, control.sch, decode.sch, dflipflops.sch, drambyte.sch, fiveof8.sch, sramcells.sch, univlight.sch]
2021-03-24 Rework decode somewhat.
    [bit.sch, decode.sch, univlight.sch, xnor.sch]
2021-03-24 Shuffle sources around
    [alu.sch, dflipflop.sch, dilatch.sch, noverlap.sch, opdecode.sch, osc.sch, pcdecode.sch, ramdecode.sch]
2021-03-24 Simplify the half-adder.
    [halfadd.sch, sp.sch, xor.sch]
2021-03-24 Adjust the ROM readout.
    [bit.sch, noverlap.sch, romio.sch]
2021-03-25 Strong load resistors in the register file.
    [sramcell2.sch, sramcell2t.sch]
2021-03-25 Use an HBT on the stack sense line, speed up O lines, gives 2µs.
    [bit.sch, romio.sch, univlight.sch]
2021-03-26 Add hazard2 test.
    A speed-up that got dropped.
    [bit.sch, decode.sch, dramio.sch]
2021-03-29 Various tidy ups.
    [bit.sch, decode.sch, diplatch.sch, dram64byte.sch, dramio.sch]
2021-04-02 Move bit & control into boards.
    [bit.sch, control.sch, universe.sch]
2021-04-02 Fix width of pads on the pci edge connector.
    [pci-edge-3v.pcb]
2021-04-02 Update symbols & footprints for the component selection we have.
    Nix old crap
    [bit.sch, control.sch, dlatch.sch, flipflops.pcb, flipflops.sch, noverlap.sch, slice.pcb, slice.sch]
2021-04-02 Touch up footprints everywhere.
    [andnand.sch, bit.sch, control.sch, decode.sch, dram64byte.sch, drambyte.sch, dramio.sch, fiveof8.sch]
2021-04-02 The layout starts.
    [bit-board.pcb, bit.sch]
2021-04-03 More layout. PC side done.
    [bit-board.pcb]
2021-04-03 DRAM refresh & address drivers.
    [bit-board.pcb]
2021-04-04 Swap in the refresh for instruction bit.
    [bit-board.pcb]
2021-04-04 ALU intraconnects
    [bit-board.pcb]
2021-04-04 Move ALU into place
    [bit-board.pcb]
2021-04-04 ALU resistors integrated
    [bit-board.pcb]
2021-04-04 HBTs rock.
    [bit.sch]
2021-04-04 Instruction reg reintegrated.
    [bit-board.pcb]
2021-04-04 Fix footprints on some resistors.
    [bit-board.pcb, decode.sch, dramio.sch, fiveof8.sch, nots.sch, noverlap.sch, romio.sch, selis.sch]
2021-04-04 Ground tidy & mesh.
    [bit-board.pcb]
2021-04-05 Tidyup and silk screen.
    [bit-board.pcb, bit.sch, decode.sch]
2021-04-05 Fix via hole size.
    [bit-board.pcb]
2021-04-05 Top fill with ground. Bottom fill with vdd.
    [bit-board.pcb]
2021-04-05 Add thermals.
    [bit-board.pcb]
2021-04-05 Remove the noverlap cap.
    [noverlap.sch]
2021-04-05 Trim board.
    [bit-board.pcb]
2021-04-07 Add bypass caps & tidy up.
    [bit-board.pcb, bit-extra.sch]
2021-04-07 Swap a couple of lines in decode.
    [decode.sch]
2021-04-08 Remove some placebos.
    [bit-board.pcb, sramcell2.sch, sramcell2s.sch, sramcell2t.sch]
2021-04-09 Shuffle a transistor out of the central column.
    [bit-board.pcb]
2021-04-10 Redo the central column.
    [bit-board.pcb]
2021-04-10 Rationalise somewhat
    [bit-board.pcb]
2021-04-11 Command board grouping.
    [bit-board.pcb, control-board.pcb]
2021-04-14 Add a board layout image.
    [bit-board.pcb, control-board.pcb]
2021-05-08 Adjust docs.
    [control.sch]
2021-06-10 Starting on the control board
    [bit-board.pcb, control-board.pcb]
2024-01-10 Miller Rabin code
2024-01-11 Split out disassemble, and add resistors
2024-01-19 Switch to lepton. Verilog updates.
    [bit-board.pcb, bit.sch, control-board.pcb, control.sch, sp.sch, univlight.sch]
2024-01-19 Get everything going with the new code.
    Fix k handling, add some Always/Never jumps.
    [instructions.rs, main.rs, programs.rs, state.rs]
2024-01-20 Add a test for the mem prefix and get it working.
    * The combinatorics was wrong.
    * Speed up a bit to meet timing.
    [decode.sch, dram16byte.sch, dram4byte.sch, dram64byte.sch, drambyte.sch, opdecode.sch]
2024-01-20 A round of simplification: The test instructions move to replace output-Y.
    [alu.sch, control.sch, decode.sch]
2024-01-20 Move QE down into decode.
    [cnot.sch, control.sch, decode.sch, deflipflop.sch, dflipflop.sch, dflipflops.sch, dielatch.sch, dilatch.sch]
2024-01-20 Shuffle things about a bit.
    [control.sch, decode.sch]
2024-01-22 Add an explicit test for flipping memory bits.
    [main.rs, programs.rs]
2024-01-22 Update ramdecode to clock the circuitry.
    [ramdecode.sch, rom64byte.sch]
2024-01-25 Tighten testing a bit, fix pcdecode test.
    [pcdecode.sch, romio.sch]
2024-01-27 Tiny tweaks.
    [dramio.sch]
2024-01-27 Rust can do inline string interpolation of variables, when did that happen?
    [rombyte.sch]
2024-01-27 Use 2.5V not 3.3V in misc. tests.
    [alu.sch, dflipflop.sch, dilatch.sch, divide.sch, flipflopbias.sch, noverlap.sch, osc.sch, pcdecode.sch]
2024-01-27 Separate out the bias supply for now.
    [dram64byte.sch, univlight.sch]
2024-02-05 Tweak labels.
    [bit.sch]
2024-02-07 Prep notb using a normal bjt.
    [notb.sch, sramcell2.sch]
2024-02-08 Add miller clamps in a few places
    [bit.sch, dpflipflops.sch, halfadd.sch, nand1or3.sch, nor1and.sch, romio.sch, selis.sch, sramcell.sch]
2024-02-08 Update docs
    [noth.sch]
2024-02-10 For univlite, use 32 bytes not 64.
    [dram32byte.sch, dramio.sch, fourp.sch, nand4od.sch, nor4.sch, rom32byte.sch, sp.sch, univlight.sch]
2024-02-10 Renumber some transistors.
    [decode.sch]
2024-02-14 Raise bias voltage for VTO high.
    Scan fix.
    [capsearch.py]
2024-02-15 Switch to rload for the stack sense.
    [bit.sch]
2024-02-15 Use saner resistors in the romio.
    [romio.sch]
2024-02-16 Speed up the memory strobing a bit. Raise bias by 200mV.
    [dram32byte.sch, dram64byte.sch]
2024-02-17 Change the bias transistor to BJT.
    [dram32byte.sch, dram64byte.sch, nand3.sch, univlight.sch]
2024-02-18 Separate dram resistors from others.
    [drambyte.sch]
2024-02-18 Rationalise rom32 a little.
    [rom32byte.sch]
2024-02-19 Go to 10k on the dram base resistor.
2024-02-22 Add the diodes to the bit board.
    [bit-board.pcb]
2024-02-22 Alt ram sense
    [decode.sch, jram16byte.sch, jram32byte.sch, jram4byte.sch, jrambyte.sch, jramio.sch, univlight.sch]
2024-02-27 JFET based dram cell
    [decode.sch, dram16byte.sch, dram32byte.sch, dram4byte.sch, dram64byte.sch, drambyte.sch, dramio.sch, jram16byte.sch]
2024-02-27 Make the sense line less trigger happy.
    [bit.sch, dram32byte.sch, dram64byte.sch, drambyte.sch, dramio.sch, ramdecode.sch, univlight.sch]
2024-02-27 Remove the clock timing from the resistor scan.
    [dram32byte.sch]
2024-02-28 Avoid glitches on vpush.
    [decode.sch]
2024-02-29 Tweak the sense pulls.
    [dramio.sch]
2024-02-29 Go back to negative feedback on dramio.
    [dramio.sch]
2024-03-02 Include the refresh counter in the verification.
    [dram64byte.sch]
2024-03-02 Tidy up.
    [decode.sch, dram32byte.sch, drambyte.sch]
2024-03-02 Tighten up due to refresh check.
    [capsearch.py]
2024-03-03 Lower the feedback resistor.
2024-03-03 Reduce the clock delay.
    [dram32byte.sch]
2024-03-05 Redo the sense line bias resistor.
    [dramio.sch]
2024-03-05 Use diodes logic on the register read.
    [bit.sch, sramcell2.sch, sramcell2s.sch, sramcell2t.sch]
2024-03-05 Tweak pulls.
    [sramcell2.sch, sramcell2s.sch, sramcell2t.sch]
2024-03-05 Rationalise resistor scans.
2024-03-05 Update Schottky diode model.
    Tidy up the sram cells.
    [bit.sch, fourpd.sch, romio.sch, sramcell2.sch, sramcell2s.sch, sramcell2t.sch]
2024-03-05 Try bat42, and speed up stack strobes.
    [bit.sch, fourpd.sch, romio.sch, sp.sch]
2024-03-06 Strong stack.
    [sp.sch]
2024-03-07 This one looks like the sweet spot
    [bit.sch, fourpd.sch, romio.sch]
2024-03-08 Use nominal Vss on ramdecode test.
    [ramdecode.sch]
2024-03-09 Weaken register resistors.
    [sramcell2.sch, sramcell2t.sch]
2024-03-09 No need for strong pull down on the register decode.
    [fiveof8.sch]
2024-03-15 Simplify ram interface.
    [decode.sch, ramdecode.sch]
2024-03-15 Convert dram write strobes to pmos.
    [dram32byte.sch, dramio.sch]
2024-03-16 Speed up WE line.
    [dram32byte.sch]
2024-03-16 Resistor tweak, shuffle co-ordinates.
    [dramio.sch]
2024-03-17 Use a better diode model.
2024-03-18 JFET tidy.
    [dram16byte.sch, dram32byte.sch, drambyte.sch]
2024-03-18 Move the dram write logic to the second stage of the interface.
    [dram32byte.sch, dramio.sch, univlight.sch]
2024-03-21 Track 32 byte changes.
    [dram64byte.sch, ramdecode.sch]
2024-03-21 Tweak resistors.
    [dram32byte.sch]
2024-03-21 Go to 470pF.
    [drambyte.sch]
2024-03-25 Remove the obsolete resistors. And thermals to vias.
    [bit-board.pcb]
2024-03-25 Make the double diodes sot23 footprint.
    [sramcell2.sch, sramcell2s.sch, sramcell2t.sch]
2024-03-25 Place and route various component changes.
    [bit-board.pcb]
2024-03-25 Weaken a pull-down.
    [romio.sch]
2024-03-26 Simplify the conditional handling.
    [decode.sch]
2024-03-27 Speed up the increment carry chains.
    [bit.sch, halfadd.sch, xor.sch]
2024-03-27 Revert R v R#
    [bit.sch]
2024-03-27 Redo the refresh; use the ALU instead of the increment, and put it into the register bank.
    [bit.sch, control.sch, decode.sch, fiveof8.sch, fivepd.sch, nand3od.sch, nor.sch, opdecode.sch]
2024-03-29 Speed up the ROM output.
    [rom32byte.sch, rom64byte.sch, romio.sch]
2024-03-29 Speed up A reg transitions.
    [sramcell2s.sch]
2024-03-29 Various speed-ups to branch/ret strobes.
    [control.sch, decode.sch, fourpd.sch, nands.sch, nors.sch, selis.sch, xnors.sch]
2024-03-29 Swap ret and misc instructions.
    [decode.sch]
2024-03-30 Restore a pull resistors, it helps.
    [bit.sch]
2024-03-30 Completely model the K register & use the STA encoding that doesn't read back.
    [emitter.rs, instructions.rs, programs.rs, spice_check.rs, state.rs]
2024-03-30 Speed some strobes that are critical to the carry chain.
    [decode.sch]
2024-03-31 Web page update.
    [dflipflop.sch, nand4od.sch, nandor.sch, nor1and3.sch, norb.sch, romio.sch]
2024-03-31 Try mosfets not bjt for the stack write.
    [bit.sch, decode.sch]
2024-04-01 Pmos for the strobe again....
    [decode.sch]
2024-04-01 Strong resistors there are useless.
    [fourpd.sch]
2024-04-01 Save a transistor on bit.
    [bit.sch]
2024-04-01 Adjust check sample timing.
2024-04-01 Speed up the carry launch.
    [decode.sch]
2024-04-02 Rationalise the last few changes.
    Back-off unnecessary ones.
    [control.sch, decode.sch, opdecode.sch, romio.sch]
2024-04-02 Fix the hazard in ret test.
    [programs.rs]
2024-04-02 Go to 620p for the DRAM.
    [drambyte.sch]
2024-04-03 Check the mosfet transconductance.
2024-04-03 Test a glitch case.
    [programs.rs]
2024-04-11 Be sensible on the MW strobe.
    [decode.sch, notps.sch]
2024-04-18 Simplify out strobe.
    [control.sch, decode.sch, opdecode.sch, univlight.sch]
2024-04-18 Exclude dram from a generic test!
    [dramio.sch]
2026-03-12 Test touch-ups.
    [drambyte.sch]
2026-03-13 Update test bounds.
    [bit-extra.sch]
2026-03-13 Starting on kicad bit board layout
    [bit-board.kicad_pcb]
2026-03-14 Bit board mostly routed.
    [bit-board.kicad_pcb]
2026-03-15 About to sort out silkscreen....
    [bit-board.kicad_pcb]
2026-03-15 Silkscreen sorted, and a little DRC clean-up.
    [bit-board.kicad_pcb]
2026-03-15 Separate the double diodes.
    [bit-board.kicad_pcb, bit-board.pcb, bit.sch, sramcell2.sch, sramcell2s.sch, sramcell2t.sch]
2026-03-15 Route the bit board connector. DRC clean.
    [bit-board.kicad_pcb, bit.sch]
2026-03-15 Tidy silkscreen a bit.
    [bit-board.kicad_pcb]
2026-03-16 Add more ground and power on the bit edge connector.
    [bit-board-pins.csv, bit-board.kicad_pcb]
2026-03-16 Correct led polarity.
    [bit-board.kicad_pcb]
2026-03-16 Optimize for base board routing.
    [bit-board-pins.csv, bit-board.kicad_pcb]
2026-03-16 Adjust footprints before renaming
2026-03-16 Rename footprints to be more systematic.
    [alu.sch, andnand.sch, bit-board.kicad_pcb, bit-extra.sch, bit.sch, cnot.sch, control.sch, decode.sch]
2026-03-17 Shuffle the connector.
    [bit-board.kicad_pcb]
2026-03-17 Start on control board.
    [control-board.kicad_pcb]
2026-03-18 Latest test updates + control board data
    [control-board-pins.csv, decode.sch]
